hackzone/cz20-badge/speaker_grill/speaker_grill.png

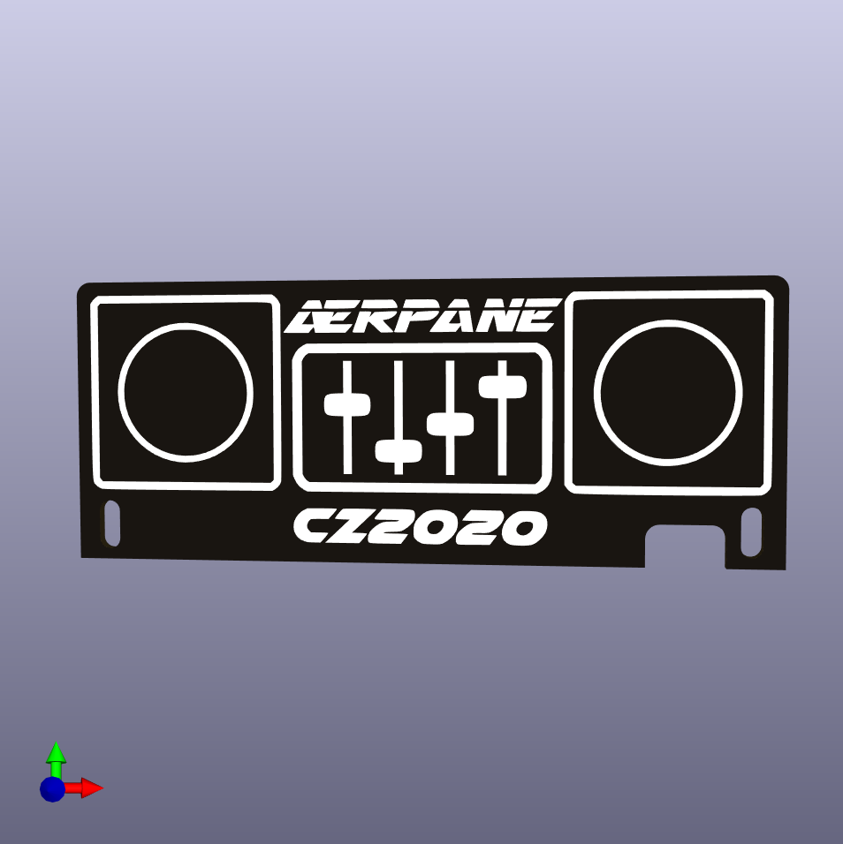
speaker_grill/speaker_grill.png
