hackzone/cz20-badge/README.md

# cz20-badge
Event badge for CampZone 2020






## [firmware-STM32](firmware-STM32)
## [bootloader-STM32](bootloader-STM32)

Use [STM32CubeIDE](https://www.st.com/en/development-tools/stm32cubeide.html)

## [firmware-ESP32](firmware-ESP32)

See [badgeteam/ESP32-platform-firmware](https://github.com/badgeteam/ESP32-platform-firmware) and [docs.badge.team](https://docs.badge.team/)

## [WebUSB site](webusb_site)

Node.js build static site for using with Hatchery over WebUSB
