hackzone/cz20-badge/speaker_grill/BoM/speaker_grill.csv

Id | Designator | Package | Quantity | Designation | Supplier and ref
1 | J4 | FFC-SMD_8P-P1.00_FFC10028-08SBD224K6M | 1 | Conn_01x08_Female
2 | J3,J2 | Molex_PicoBlade_53261-0271_1x02-1MP_P1.25mm_Horizontal | 2 | Conn_01x02_Female
3 | J1 | DNP | 1 | Conn_02x03_Odd_Even
