hackzone/cz20-badge/flashing_jig/CZ20_jig.stl

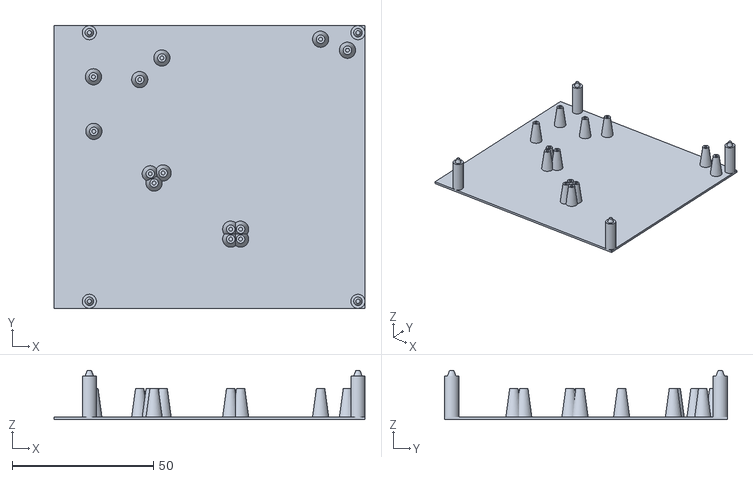
[picture p2: CAD file, 2020-07-30]
flashing_jig/CZ20_jig.stl
110.0 x 100.0 x 17.5
