hackzone/cz20-badge/hardware/hinge_light.stl

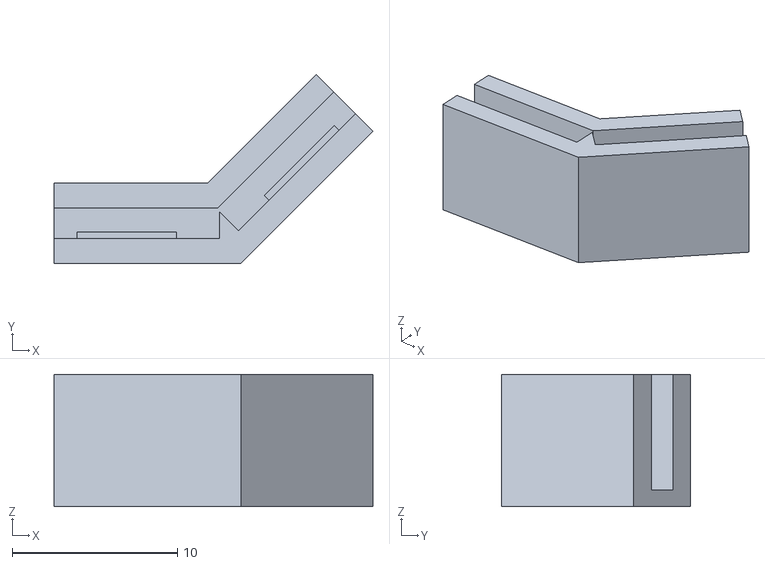
[picture p3: CAD file, 2020-07-30]
hardware/hinge_light.stl
19.3 x 11.4 x 8.00
