hackzone/cz20-badge/hardware/hinge_light_w_base.stl

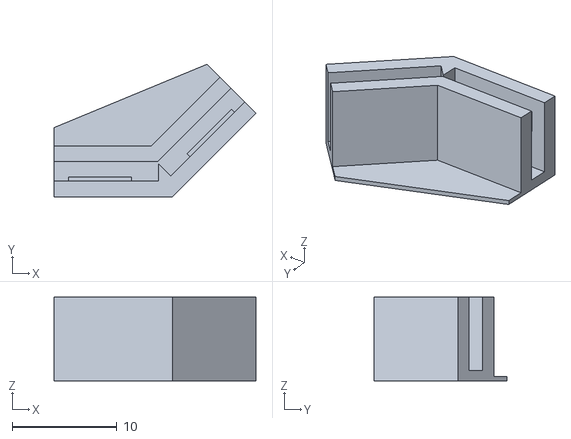
[picture p4: CAD file, 2020-07-30]
hardware/hinge_light_w_base.stl
19.3 x 12.7 x 8.00
