hackzone/cz20-badge/hardware/hinge.stl

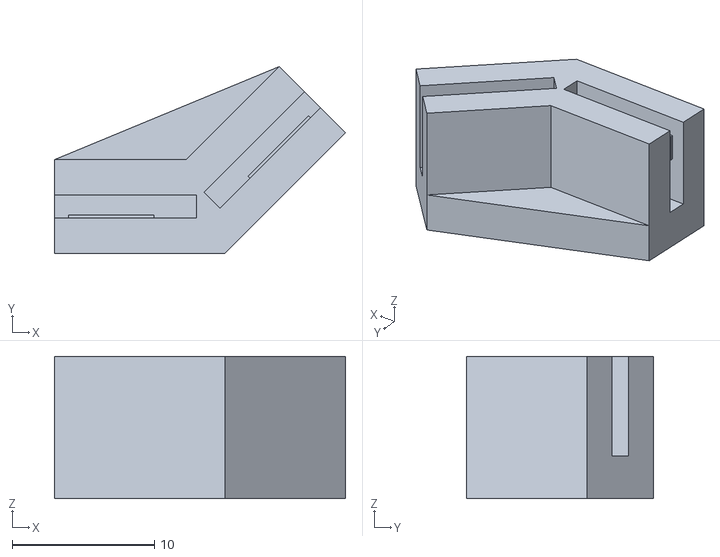
[picture p5: CAD file, 2020-05-23]
hardware/hinge.stl
20.5 x 13.2 x 10.0
