hackzone/cz20-badge/(threads)

Thread 11 (2020-07-21):

TTS loop even when having a metadata.json

therealprocyon, 2020-07-21:
I have a metadata.json set, as well as made my own app, but it becomes a buggy name and the tts keeps looping...

tjclement, 2020-07-21:
Do any errors shop up in the terminal during the loop?

therealprocyon, 2020-07-21:
` [0;37;40mStarting app 'launcher'...
>>> Preparing TTS:  Animal Crossing
TTS: Success
Preparing TTS:  Animal Crossing
Starting app 'launcher'...
>>> Starting app 'ACFAQ'...
>>> key event
i2c read error [Errno 5] EIO
key event
i2c read error [Errno 5] EIO`

tjclement, 2020-07-21:
Interesting, so even though the TTS download succeeds, it tries to download it again afterwards. Do you have /flash/cache/appnames/animal_crossing.mp3 in your file system?

therealprocyon, 2020-07-21:
No, it's named ACFAQ.mp3

therealprocyon, 2020-07-21:
On windows it says "filetype is unsupported"

tjclement, 2020-07-21:
Yeah downloading mp3 files as a zip in the web interface currently corrupts them somehow. We should log that as a separate issue; perhaps you would be kind enough to do it?

As for the TTS: does /flash/apps/ACFAQ/metadata.json exist? Note that the app "slug" name is case sensitive here

therealprocyon, 2020-07-21:
yeah it exists, apparently it generates as .MP3 with caps...

therealprocyon, 2020-07-21:
Wait, slug is missing

therealprocyon, 2020-07-21:
lemme check again

therealprocyon, 2020-07-21:
still nothing

therealprocyon, 2020-07-21:
has to do wiith it generating an all-caps filename

therealprocyon, 2020-07-21:
it generates all caps and then doesn't work when the fileslug is in all-caps

tjclement, 2020-07-21:
Cheers! Should be fixed in firmware 2104 (uploading, should be available in ~10 mins). Could you check if it works and close the issue if it does?

therealprocyon, 2020-07-21:
sure

therealprocyon, 2020-07-21:
fixed, can be closed

Closed 2020-07-21.

Thread 12 (2020-07-21):

App's failing to connect to WiFi

ijsklont, 2020-07-21:
Badge allows me to download and update firmware trough WiFi (confirmed working on both home WiFi and phone AP), however apps that require WiFi connection fail to connect to WiFi.

davidweterings, 2020-07-22:
I have similiar issues, but mine won't ever connect to my wifi (which is using an emoji), but it also won't connect to my phone's hotspot. I tried messing around a bit with the python terminal + wifi module, but no luck so far :)...

therealprocyon, 2020-07-22:
I figured how it appears to happen: there are 2 possible issues: opening settings again after having set WiFi, or on reboot by using the touch home button.

tjclement, 2020-07-22:
@renzenicolai @annejan we might want to look into the sta_if.scan() bug mentioned by @davidweterings.

@therealprocyon can you elaborate what you mean? I'm not sure I follow.

@ijsklont I'm not able to reproduce this, and have no idea what might be causing your problems. Sorry!

therealprocyon, 2020-07-22:
@tjclement if you use the home button it may reset wifi, not sure. Could also be opening settings in the browser after having set Wifi, as it blanks out when you reopen it in browser that is.

tjclement, 2020-07-22:
Yeah the home button does a full reboot, and then the launcher starts again. This is to start apps from a fresh state always. A consequence is that wifi is not connected then.

The wifi setting being cleared when you open the page again is just on the web side. We don't save the credentials, so they disappear.

therealprocyon, 2020-07-22:
that explains it.

therealprocyon, 2020-07-22:
might want to add it to the docs...

therealprocyon, 2020-07-22:
such as that people will add other ways to exit apps...

therealprocyon, 2020-07-22:
that may be the issue. What also could be nifty is having a method of storing wifi stuff on the SD, so it could be read from there.

tjclement, 2020-07-22:
I don't think that's what @ijsklont and @davidweterings are reporting: their wifi isn't working at all. Every app that uses wifi initialises it themselves (as they should). For @ijsklont, however, connecting in python apps fails, whereas the OTA update written in C works. That's odd.

therealprocyon, 2020-07-22:
ah that's odd... in my case 9/10 times it fails too

annejan, 2020-07-22:
> that may be the issue. What also could be nifty is having a method of storing wifi stuff on the SD, so it could be read from there.

The WIFI settings are stored in NVS on the badge, the webUSB site doesn't store them . .

I only have badge WiFI issues in places with terrible 2.4 GHz pollution . . where my other (5GHz) devices don't have issues . .
Wondering how I can replicate the issues you are having.

ijsklont, 2020-07-23:
After updating to 20072205 this morning, i was able to have an app connect to wifi (538 Radio). However after pressing home and test another radio app, the wifi isnt connecting anymore for all the apps.

therealprocyon, 2020-07-23:
if I init the app from the launcher, it works. otherwise it doesn't.

stitch, 2020-08-04:
My experiences with Wifi are solid, with only one workaround:

The wifi code in many of the radio apps, with the voice saying something didn't work out. Instead i wrote this routine:

No13, 2020-08-05:
I was checking newer esp-idf versions, these lib's will do the wifi handling of the ESP chip. Apparently the 'logic' of the ESP will prefer the lowest channel over a better RSSI :-/
You can supply a channel on the sta connect() function but it didn't do anything for me

Closed 2023-09-09.

Thread 13 (2020-07-22):

Bootloop: "Generating a spoken name for app"

D3xtar, 2020-07-22:
Badge runs into a bootloop, and keeps repeating " Generating a spoken name for app" , following a short beep which seems to be caused by the reboot that follows.

Actions that have been done that could possibly triggered this bootloop:

-Updated to the newest firmware
-Installed/Deinstalled some apps from the store,
-Made a test-app through the web-interface. Manually made some directories and files in the "Apps" -folder.
-Moved around some buttons.

All apps have been removed, but the problem persists. Apps are bootable when you press the button right before the spoken message.

Terminal output:
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

D3xtar, 2020-07-22:
Update: Removed SD card and booted. Spoken name is now generated correctly! After reinserting the SD still no errors.

tjclement, 2020-07-22:
Fascinating, thanks for reporting. I'll try to reproduce this later

jorisplusplus, 2020-07-22:
Disabling Use interrupt for MPI operations seems to fix the bootloop and will generate the tts files while sd card is present. Impact of this change is unknown

tjclement, 2020-07-22:
Testing now

tjclement, 2020-07-22:
Fixed in firmware 2205! Please reopen the issue if you're still having trouble

Closed 2020-07-22.

Thread 14 (2020-07-22):

Reboots when starting app launcher (or other apps)

D3xtar, 2020-07-22:
After creating/deleting some files in the Apps folder, the launcher app crashes. Terminal shows the following output:

`BADGE.TEAM
Starting app 'launcher'...
>>> assertion "0 && "fatfs internal error"" failed: file "/Users/tom/Git/cz20-badge/firmware-ESP32/esp-idf/components/fatfs/src/vfs_fat.c", line 251, function: fresult_to_errno
abort() was called at PC 0x40119cdb on core 1

Backtrace: 0x4009318f:0x3ffc0bc0 0x40093489:0x3ffc0be0 0x40119cdb:0x3ffc0c00 0x4018777c:0x3ffc0c30 0x40187a4a:0x3ffc0c50 0x40134e46:0x3ffc0c80 0x4000bdbb:0x3ffc0ca0 0x400017ea:0x3ffc0cc0 0x4010bb51:0x3ffc0ce0 0x40119996:0x3ffc0d00 0x40146754:0x3ffc0d20 0x40145966:0x3ffc0d50 0x40145b06:0x3ffc0d90

Rebooting...
ets Jul 29 2019 12:21:46

rst:0xc (SW_CPU_RESET),boot:0x13 (SPI_FAST_FLASH_BOOT)
configsip: 0, SPIWP:0xee
clk_drv:0x00,q_drv:0x00,d_drv:0x00,cs0_drv:0x00,hd_drv:0x00,wp_drv:0x00
mode:DIO, clock div:1
load:0x3fff0018,len:4
load:0x3fff001c,len:5192
load:0x40078000,len:9088
ho 0 tail 12 room 4
load:0x40080400,len:6652
entry 0x400806f8
`
This appears every 2 seconds.

Web interface is accessible. Pressing a button to start an app does not start the app..

D3xtar, 2020-07-22:
Message disppears when removing all apps, bu re-appears when installing an app from the store. Starting apps not possible.

D3xtar, 2020-07-22:
Also appears when starting other apps:

BADGE.TEAM
Starting app 'qmusic_radio'...
assertion "0 && "fatfs internal error"" failed: file "/Users/tom/Git/cz20-badge/firmware-ESP32/esp-idf/components/fatfs/src/vfs_fat.c", line 251, function: fresult_to_errno
abort() was called at PC 0x40119cdb on core 1

Backtrace: 0x4009318f:0x3ffd59b0 0x40093489:0x3ffd59d0 0x40119cdb:0x3ffd59f0 0x4018777c:0x3ffd5a20 0x40187a4a:0x3ffd5a40 0x40134e46:0x3ffd5a70 0x4000bdbb:0x3ffd5a90 0x400017ea:0x3ffd5ab0 0x4010bb51:0x3ffd5ad0 0x40119996:0x3ffd5af0 0x40146754:0x3ffd5b10 0x40145966:0x3ffd5b40 0x40145b06:0x3ffd5b80

Rebooting...
ets Jul 29 2019 12:21:46

rst:0xc (SW_CPU_RESET),boot:0x13 (SPI_FAST_FLASH_BOOT)
configsip: 0, SPIWP:0xee
clk_drv:0x00,q_drv:0x00,d_drv:0x00,cs0_drv:0x00,hd_drv:0x00,wp_drv:0x00
mode:DIO, clock div:1
load:0x3fff0018,len:4
load:0x3fff001c,len:5192
load:0x40078000,len:9088
ho 0 tail 12 room 4
load:0x40080400,len:6652
entry 0x400806f8

D3xtar, 2020-07-22:
In every attemp to start an app this lie always show up:

"fatfs internal error"" failed: file "/Users/tom/Git/cz20-badge/firmware-ESP32/esp-idf/components/fatfs/src/vfs_fat.c",

tjclement, 2020-07-22:
This looks like the FS got corrupted somehow. Maybe the file allocation table is bad. That's unfortunate, because we don't have an easy way to fix this yet. Let's PM about what to do for you. I'll leave this issue open so others can find it, should they run into the same problem (if you do, please add a message here).

D3xtar, 2020-07-22:
Restored ESP by reflashing. Thank you!

D3xtar, 2020-07-22:
After making some new folders/files the problem reappeared:

BADGE.TEAM
Starting app 'qmusic_radio'...
assertion "0 && "fatfs internal error"" failed: file "/Users/tom/Git/cz20-badge/firmware-ESP32/esp-idf/components/fatfs/src/vfs_fat.c", line 251, function: fresult_to_errno
abort() was called at PC 0x40119cdb on core 1

Backtrace: 0x4009318f:0x3ffd59b0 0x40093489:0x3ffd59d0 0x40119cdb:0x3ffd59f0 0x4018777c:0x3ffd5a20 0x40187a4a:0x3ffd5a40 0x40134e46:0x3ffd5a70 0x4000bdbb:0x3ffd5a90 0x400017ea:0x3ffd5ab0 0x4010bb51:0x3ffd5ad0 0x40119996:0x3ffd5af0 0x40146754:0x3ffd5b10 0x40145966:0x3ffd5b40 0x40145b06:0x3ffd5b80

Rebooting...
ets Jul 29 2019 12:21:46

rst:0xc (SW_CPU_RESET),boot:0x13 (SPI_FAST_FLASH_BOOT)
configsip: 0, SPIWP:0xee
clk_drv:0x00,q_drv:0x00,d_drv:0x00,cs0_drv:0x00,hd_drv:0x00,wp_drv:0x00
mode:DIO, clock div:1
load:0x3fff0018,len:4
load:0x3fff001c,len:5192
load:0x40078000,len:9088
ho 0 tail 12 room 4
load:0x40080400,len:6652
entry 0x400806f8

reflashed  and everything works again.

tjclement, 2020-07-22:
Can you describe the folders/files? If you're not doing anything crazy, you might have faulty flash storage. If so, we'll arrange something for you.

annejan, 2020-07-22:
If after reflash no more issues . . then that's it . .

If you continue to experience issues . . you'll need a replacement board / ESP 😉

Closed 2020-07-22.

Thread 15 (2020-07-22):

Apps fail to update

xesxen, 2020-07-22:
The WebUSB environment tries to create the paths it needs when installing an app (https://github.com/hackzone/cz20-badge/blob/master/webusb_site/src/components/Apps.vue#L221). When updating, this isn't needed.

As it currently doesn't take this into account, the Javascript promise will fail which results in the vue component ending up in an improper state (you cannot install anymore apps till you refresh).

tjclement, 2020-07-22:
This fix will be pushed momentarily (together with progress bar update)

tjclement, 2020-07-22:
Fixed

Closed 2020-07-22.

Thread 16 (2020-07-22):

[Feature request] Adding optional settings fields in the "Configure home screen buttons"

MrDiba, 2020-07-22:
I have build the MQTT button app where the user needs to enter information (MQTT server IP, and topic) in the code before the application can be used.

It would be great if the user can enter the information on the "configure home screen buttons" and that it is parsed over to the application. I do not know if it is (technically) possible or not, but I would like to throw the suggestion.

The idea is that the app creator can add fields (text boxes, radio buttons, ...) to the selected app in the "configure home screen buttons" view. A placeholder variable can be placed in the Python code in the app, and when information is entered in the field the data will be parsed to the variable in the Python code.

tjclement, 2020-07-22:
Wonderful idea, and already implemented! 😁 https://docs.badge.team/esp32-app-development/api-reference/appconfig/

This adds per-app boxes to the Settings page after your app first runs:
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

Closed 2020-07-22.

Thread 19 (2020-07-23):

Generating spoken name for app message after assigning local app to button

D3xtar, 2020-07-23:
I manually created some directories under the " Apps"  folder to store my own projects.

When assigning such a project to one of the buttons, the message "generating spoken name for app" appears every time you return to the home-state with the home-button.

Terminal screen output: Skipping app name generation due to earlier error.

tjclement, 2020-07-23:
Fixed in firmware 2307!

Closed 2020-07-23.

Thread 22 (2020-07-23):

[webusb site] Programming view is broken after switching to another view

tjclement, 2020-07-23:
Throws an error about handleLog not being available on undefined object.

tjclement, 2020-07-23:
Fixed in latest webusb release

Closed 2020-07-23.

Thread 24 (2020-07-24):

Feature request: Possibility to record samples in webui

jillesdotcom, 2020-07-24:
Allow users to record mono samples @ 22.050 128kps in the Webui and upload those to /flash/cache/samples/sample<n>.mp3
Users are able to move those to different apps and rename them accordingly.

sknebel, 2020-08-01:
Since I had looked at some pieces that would be relevant recently, here's some hints for a potential implementation:

You'll need to bring your own MP3 encoder. There are a few projects that have compiled LAME to JS or WASM through emscripten, e.g. https://github.com/Kagami/vmsg

What it is missing is a sample-rate conversion - this could either be done by adding some conversion code to the C module or by pre-converting in JS.

sknebel, 2020-08-01:
addendum: to state it explicitly, I'd be willing to help figure some of this out, but can't do the integration into the app since I missed out on a badge and thus can't run/test it.

annejan, 2020-08-02:
I have conversion options in Hatchery, I can setup an opus to mp3 converter somewhere coming week.

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

--
Sent from my badge prototype
