hackzone/cz20-badge/hardware/pdf/cz-badge-hardware-B_SilkS.pdf

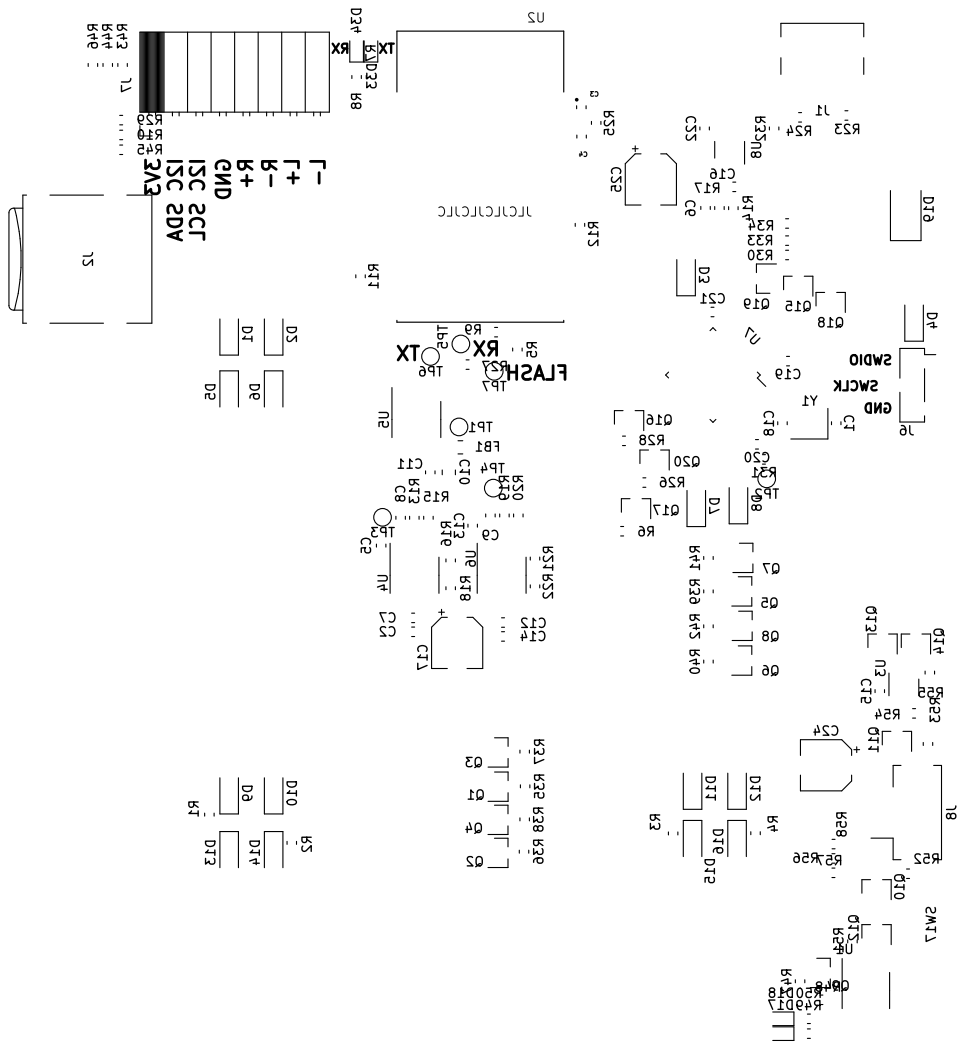
[picture p6: page 1]

FLASH 3V3 I2C SDA I2C SCL GND R+R- L+L- GND
