hackzone/cz20-badge/hardware/pdf/cz-badge-hardware-F_SilkS.pdf

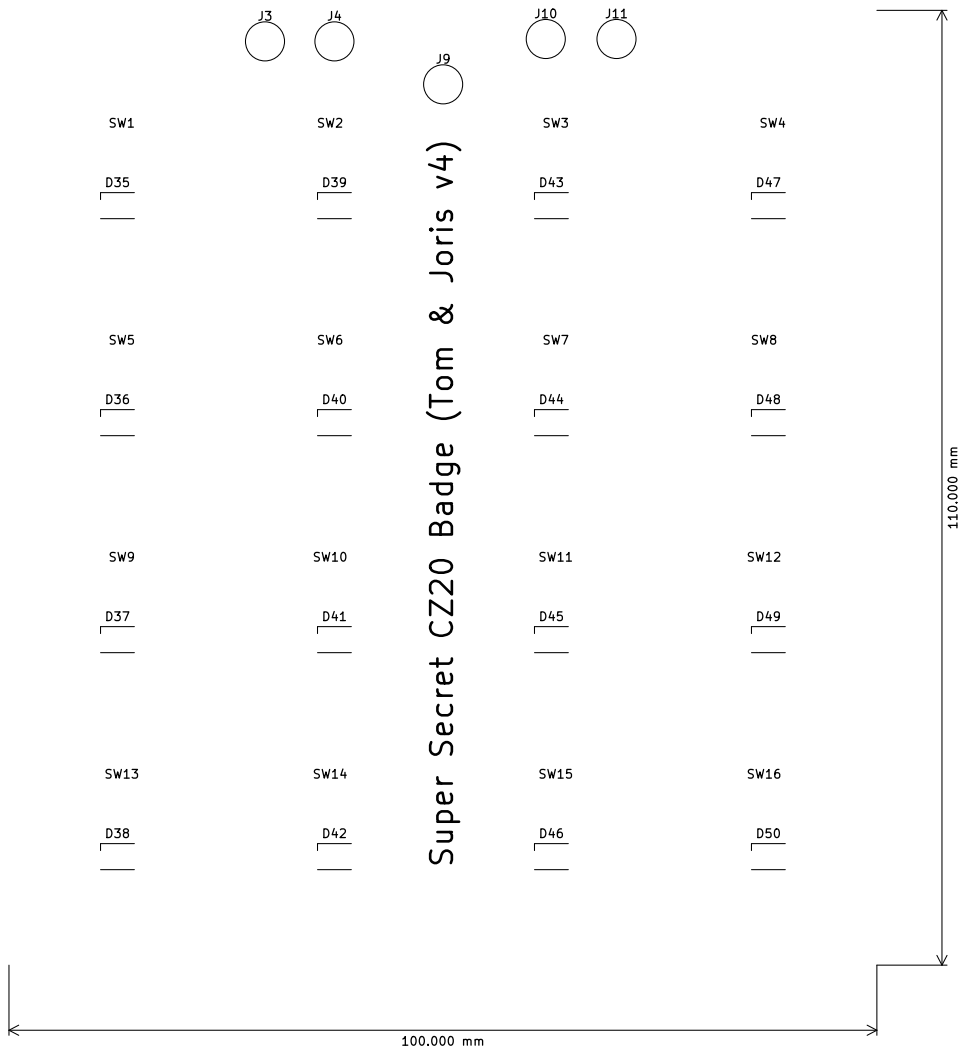
[picture p7: page 1]

100.000 mm Super Secret CZ20 Badge (Tom & Joris v4)
