hackzone/cz20-badge/speaker_grill/pdf/panel-B_Mask.pdf

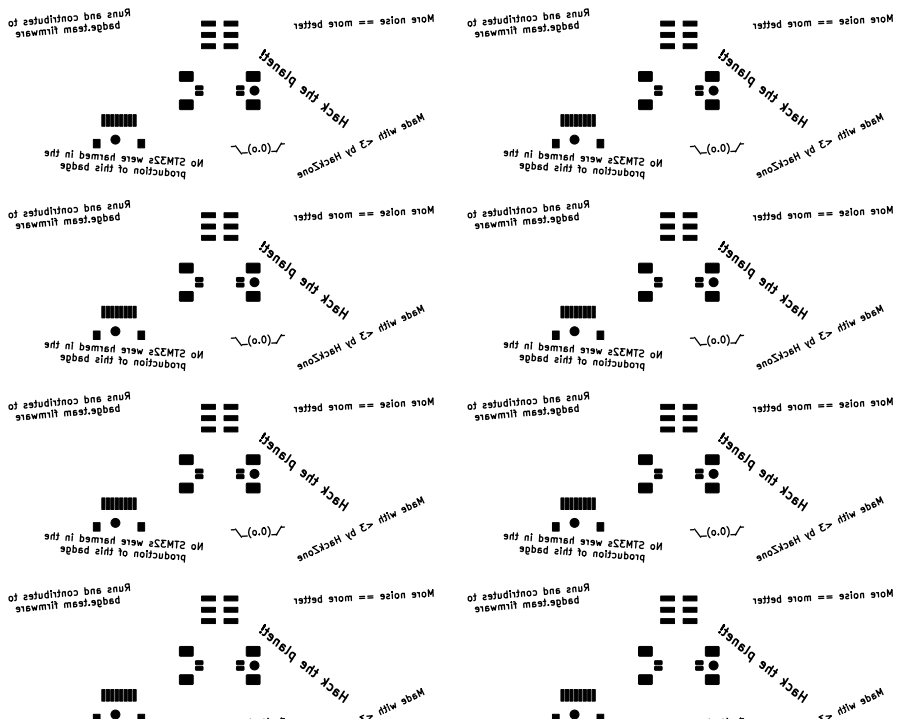
[picture p8: page 1]

Runs and contributes to badge.team firmware

More noise == more better

Hack the planet! Made with <3 by HackZone

No STM32s were harmed in the production of this badge
