hackzone/cz20-badge/speaker_grill/pdf/panel-Cmts_User.pdf

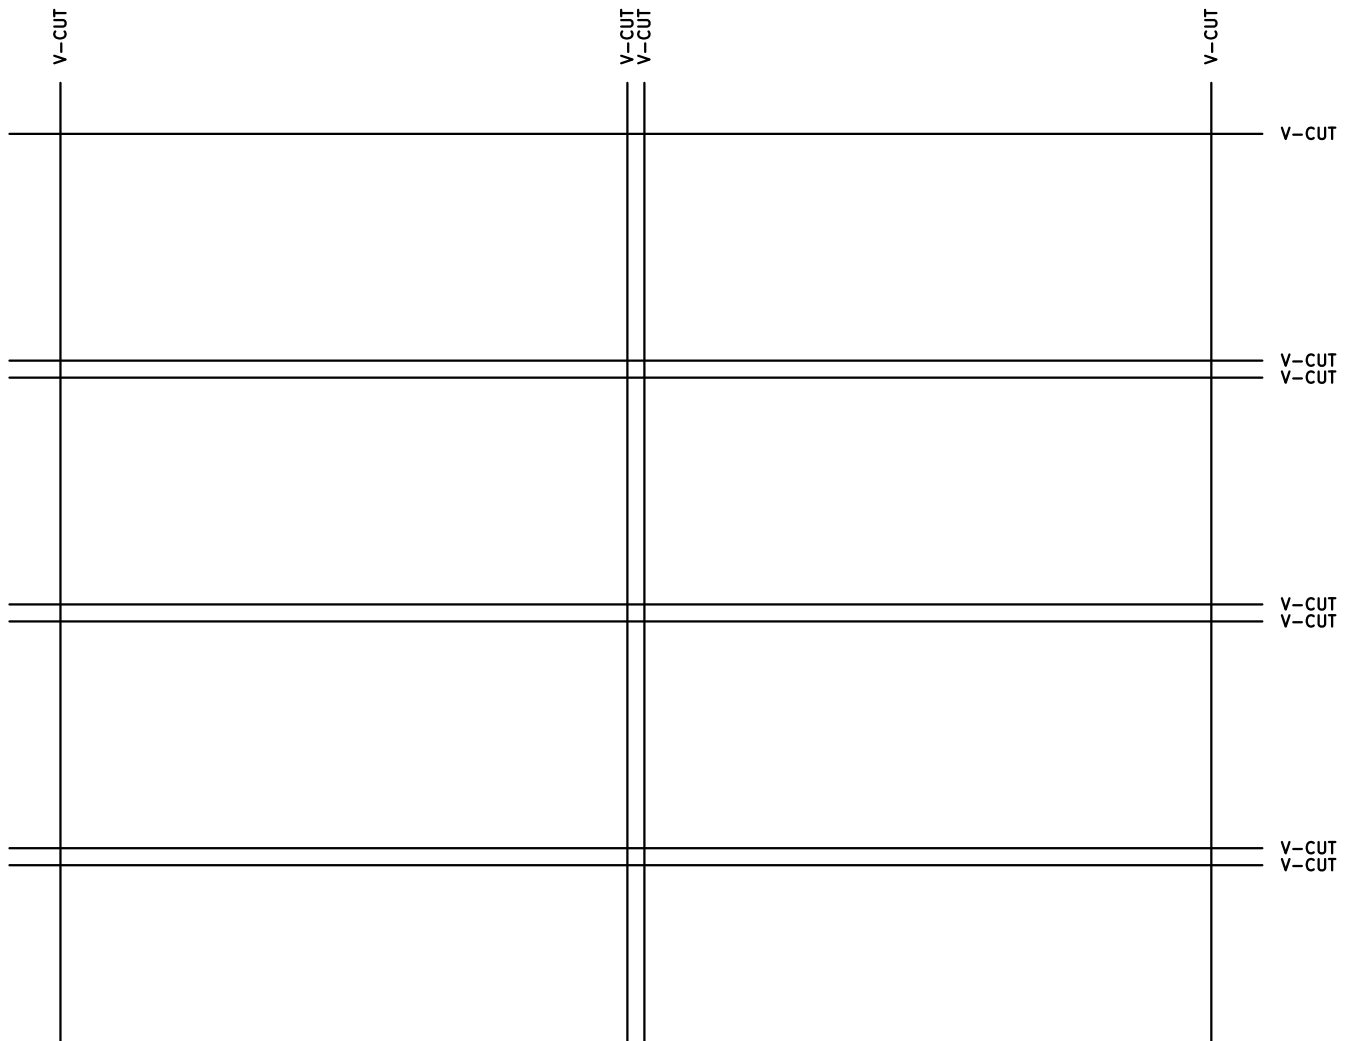
[picture p9: page 1]

V-CUT V-CUT
