hackzone/cz20-badge/hardware/pdf/cz-badge-hardware-B_CrtYd.pdf

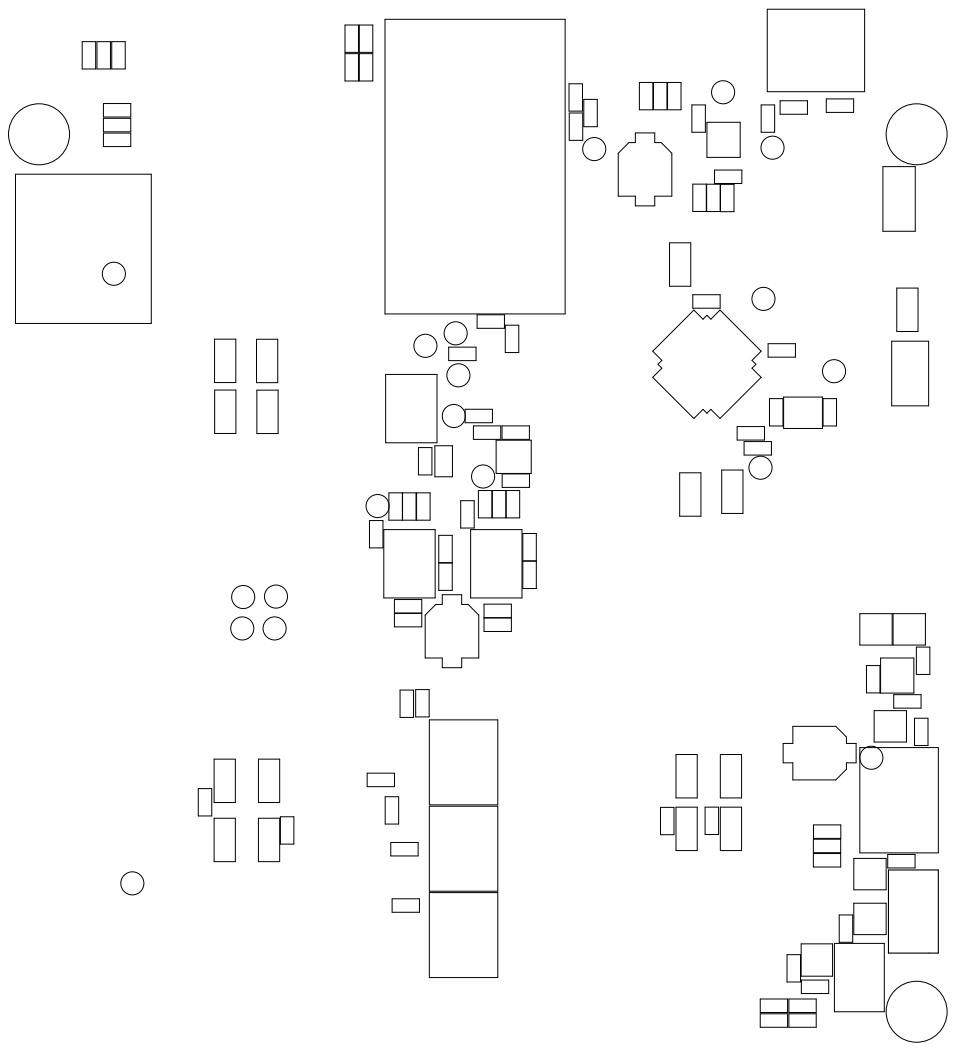
[picture p10: page 1]
