hackzone/cz20-badge/hardware/pdf/cz-badge-hardware-F_CrtYd.pdf

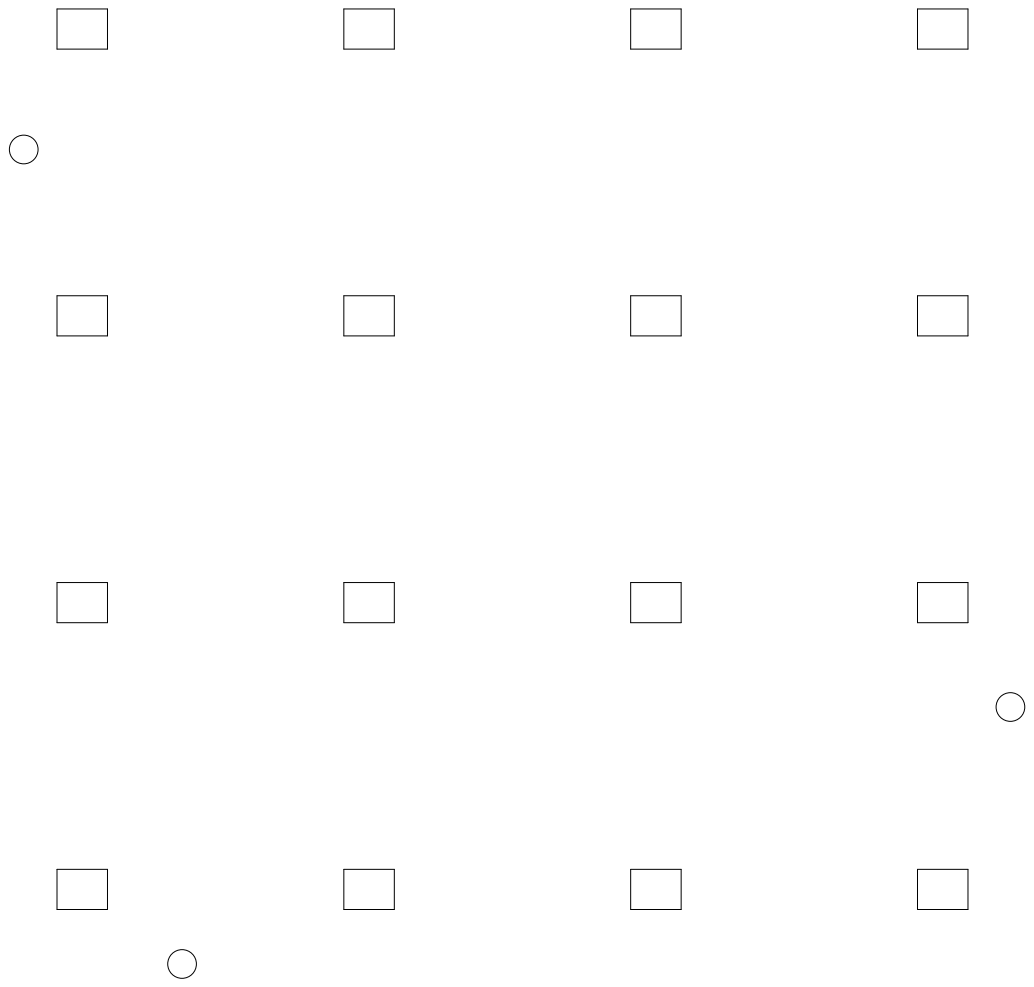
[picture p11: page 1]
