hackzone/cz20-badge/hardware/pdf/cz-badge-hardware-B_Cu.pdf

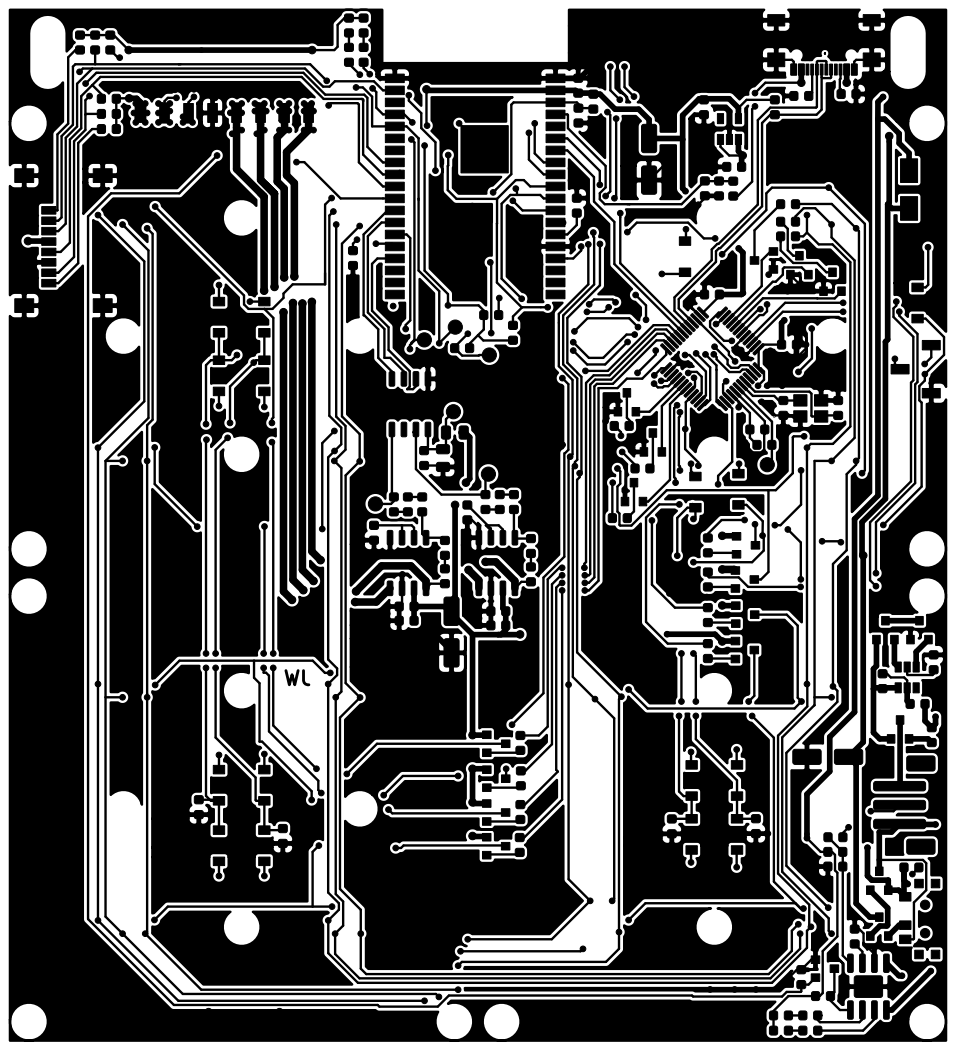
[picture p12: page 1]
