hackzone/cz20-badge/hardware/pdf/cz-badge-hardware-B_Fab.pdf

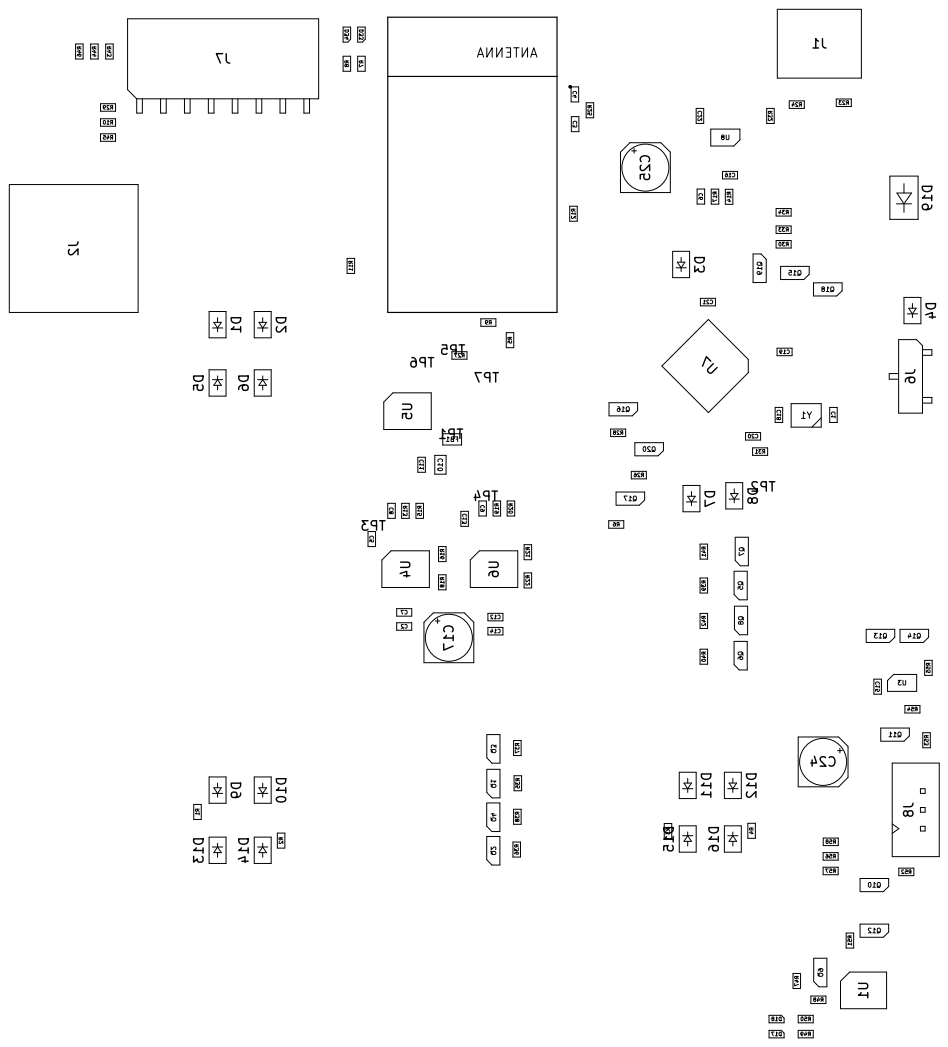
[picture p13: page 1]
