hackzone/cz20-badge/hardware/pdf/cz-badge-hardware-B_Mask.pdf

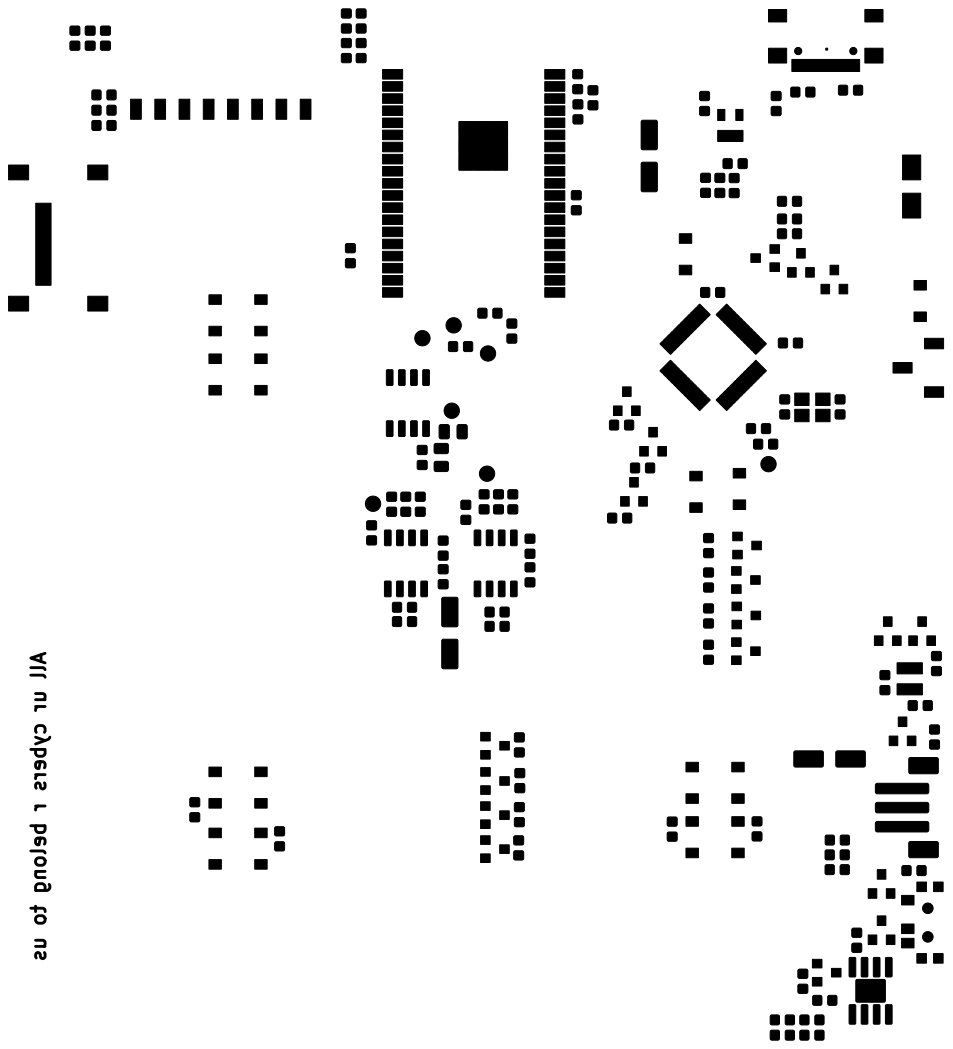
[picture p14: page 1]

All ur cybers r belong to us
