hackzone/cz20-badge/hardware/pdf/cz-badge-hardware-B_Paste.pdf

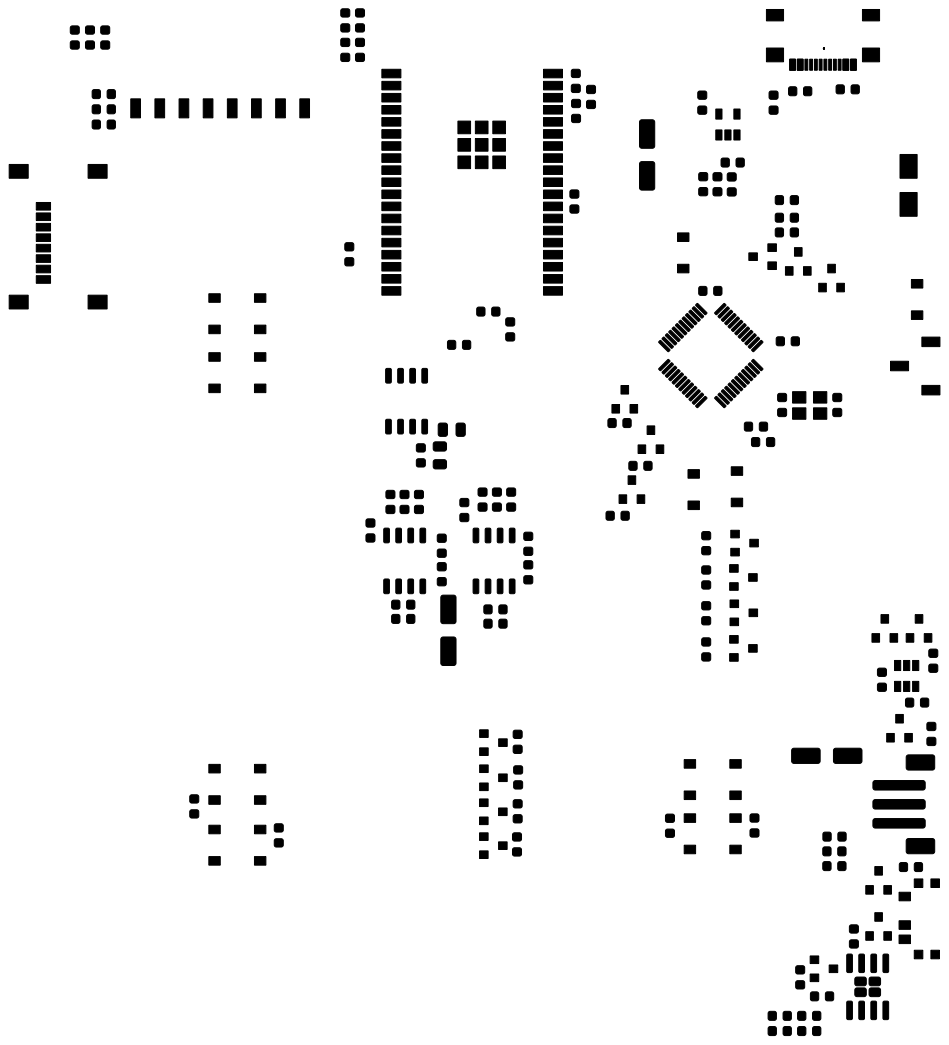
[picture p15: page 1]
