hackzone/cz20-badge/hardware/pdf/cz-badge-hardware-Edge_Cuts.pdf

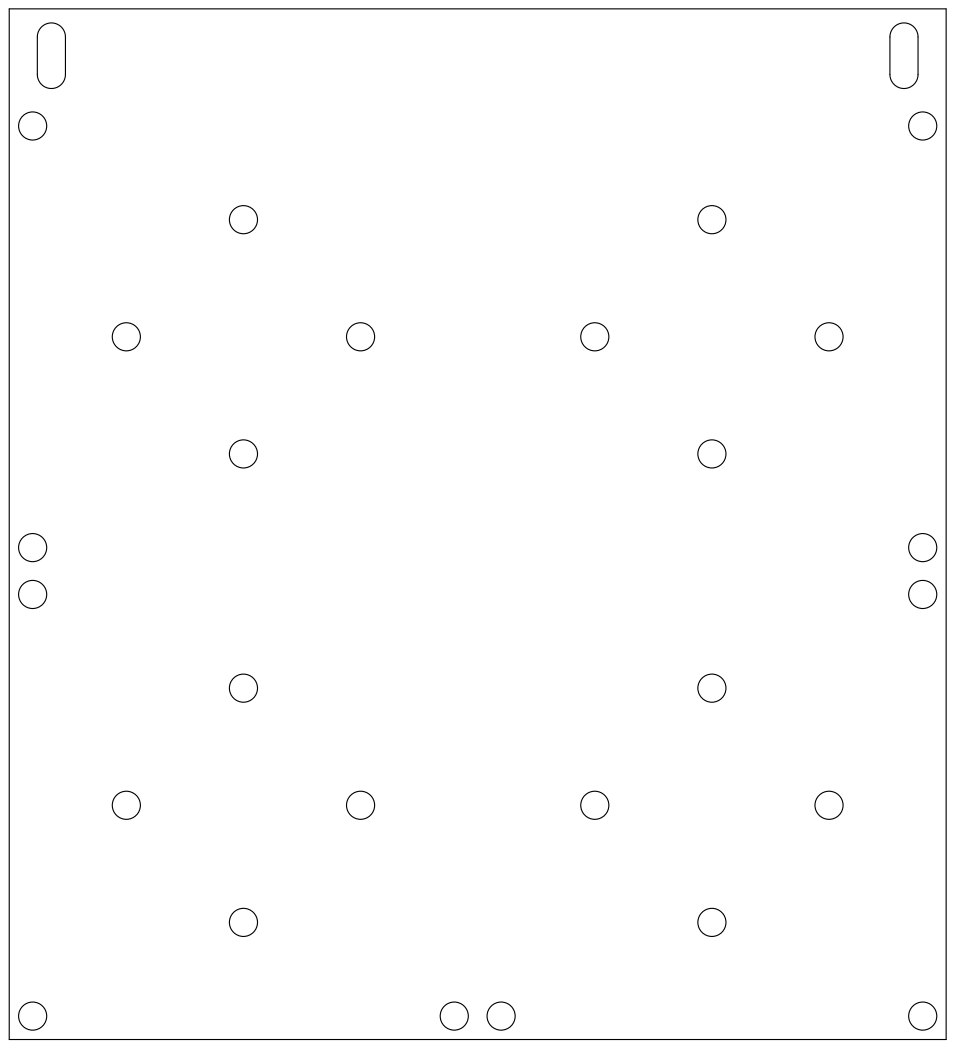
[picture p16: page 1]
