hackzone/cz20-badge/hardware/pdf/cz-badge-hardware-F_Cu.pdf

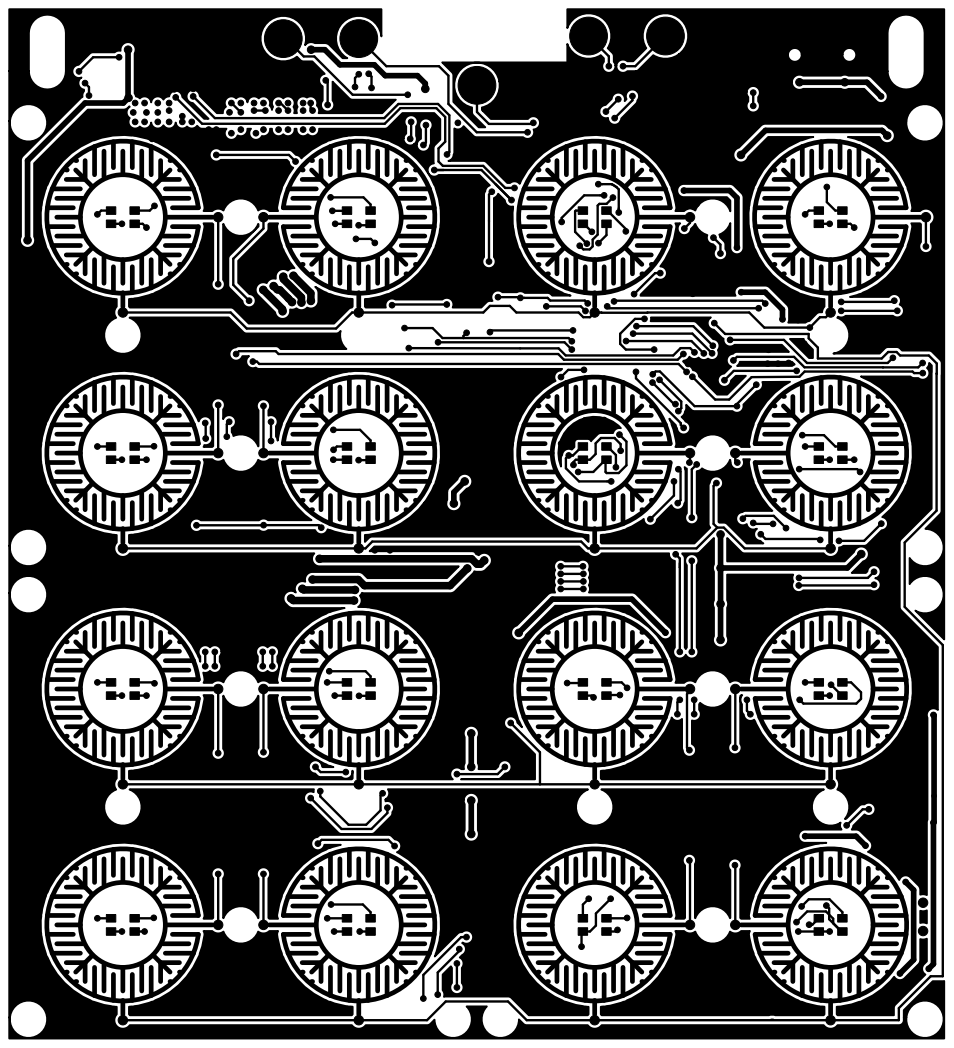
[picture p17: page 1]
