hackzone/cz20-badge/hardware/pdf/cz-badge-hardware-F_Fab.pdf

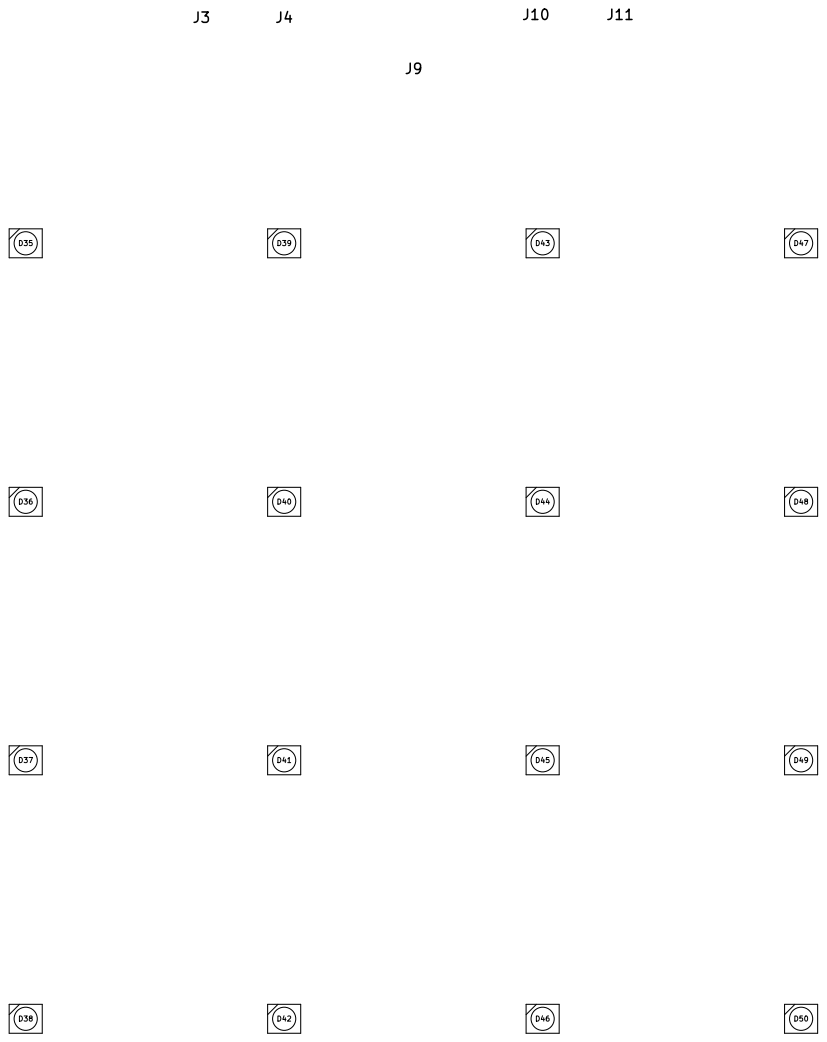
[picture p18: page 1]
