hackzone/cz20-badge/hardware/pdf/cz-badge-hardware-F_Mask.pdf

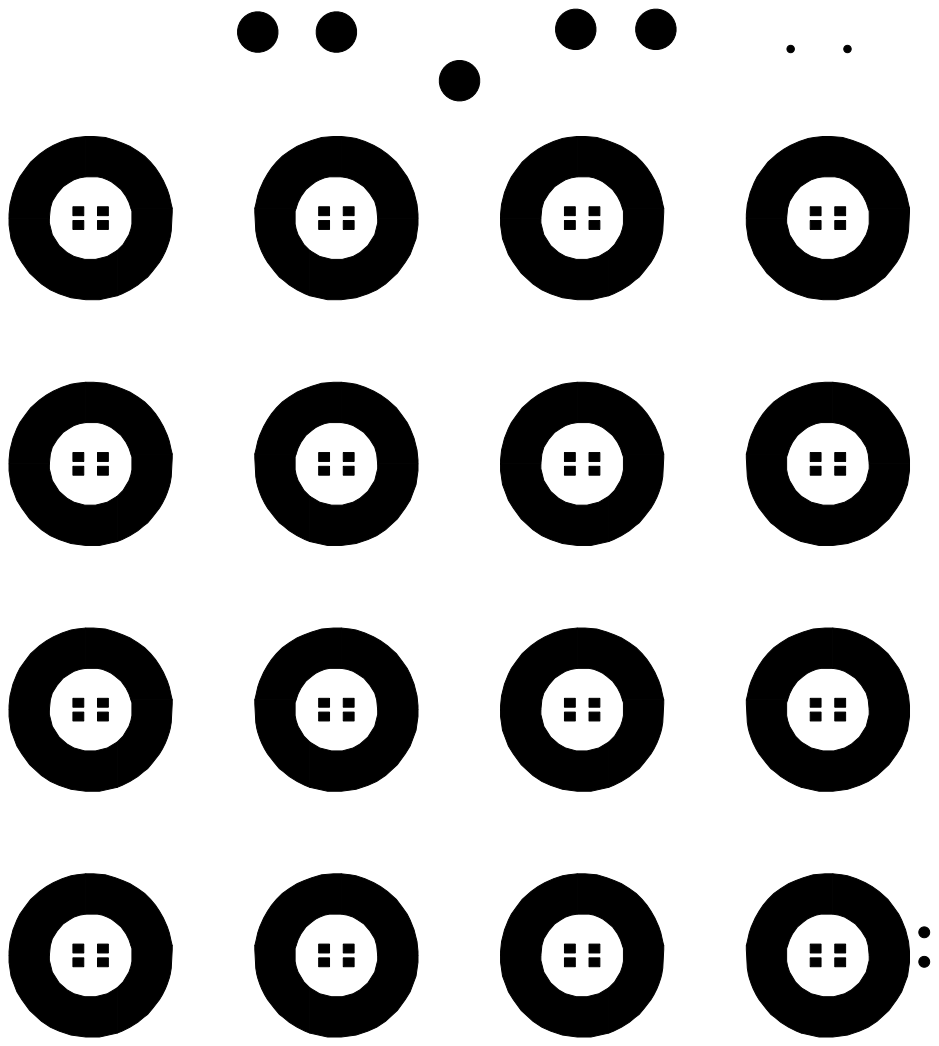
[picture p19: page 1]
