hackzone/cz20-badge/hardware/pdf/cz-badge-hardware-F_Paste.pdf

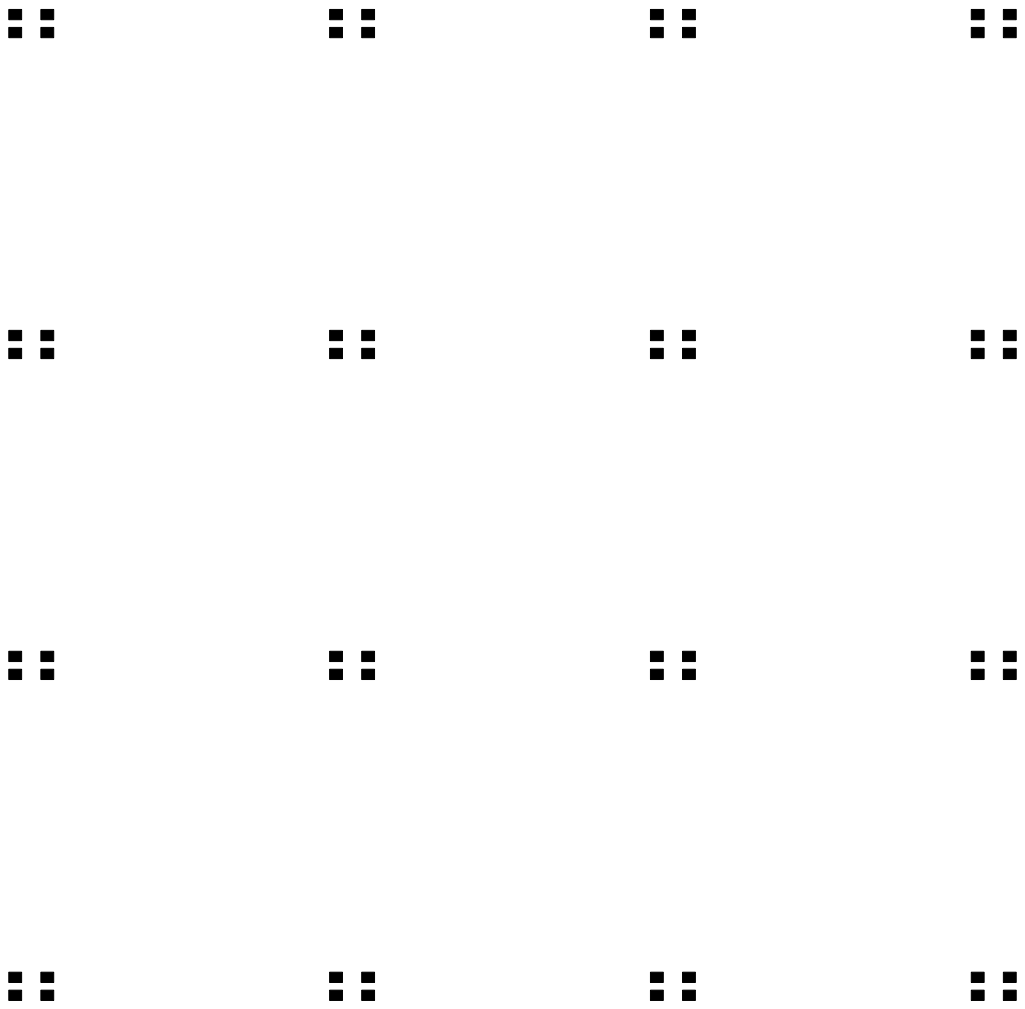
[picture p20: page 1]
