hackzone/cz20-badge/speaker_grill/pdf/panel-B_CrtYd.pdf

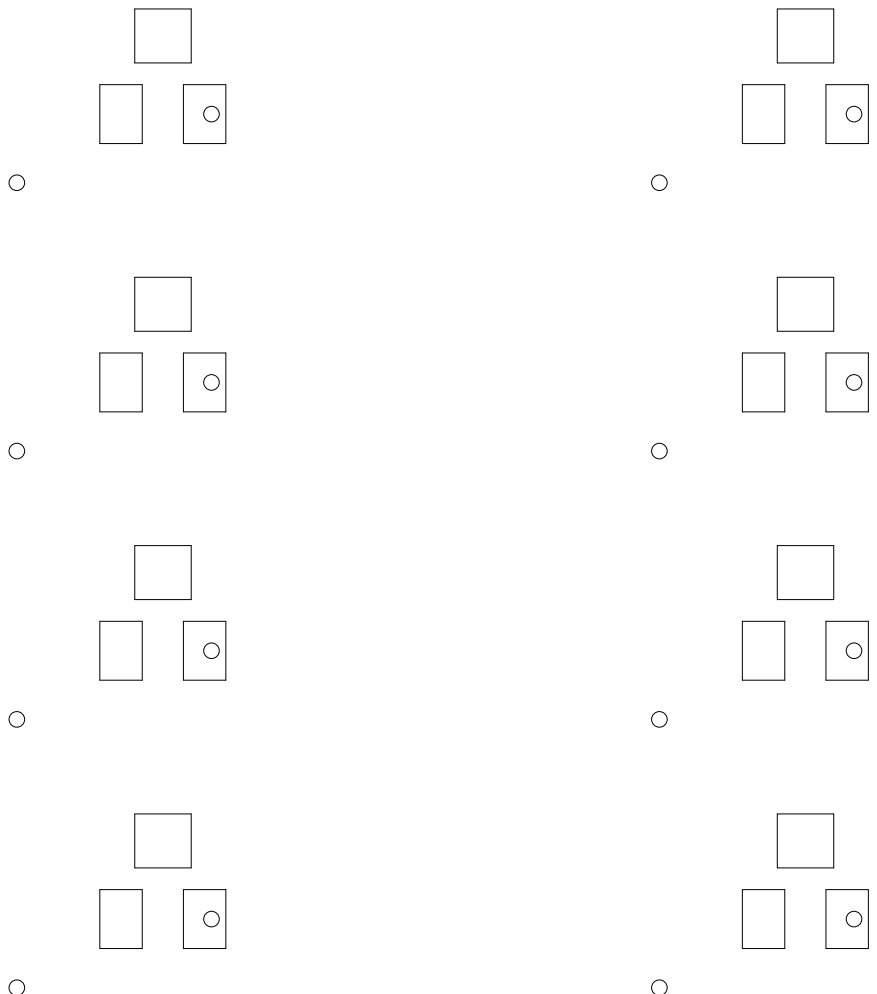
[picture p21: page 1]
