hackzone/cz20-badge/speaker_grill/pdf/panel-B_Cu.pdf

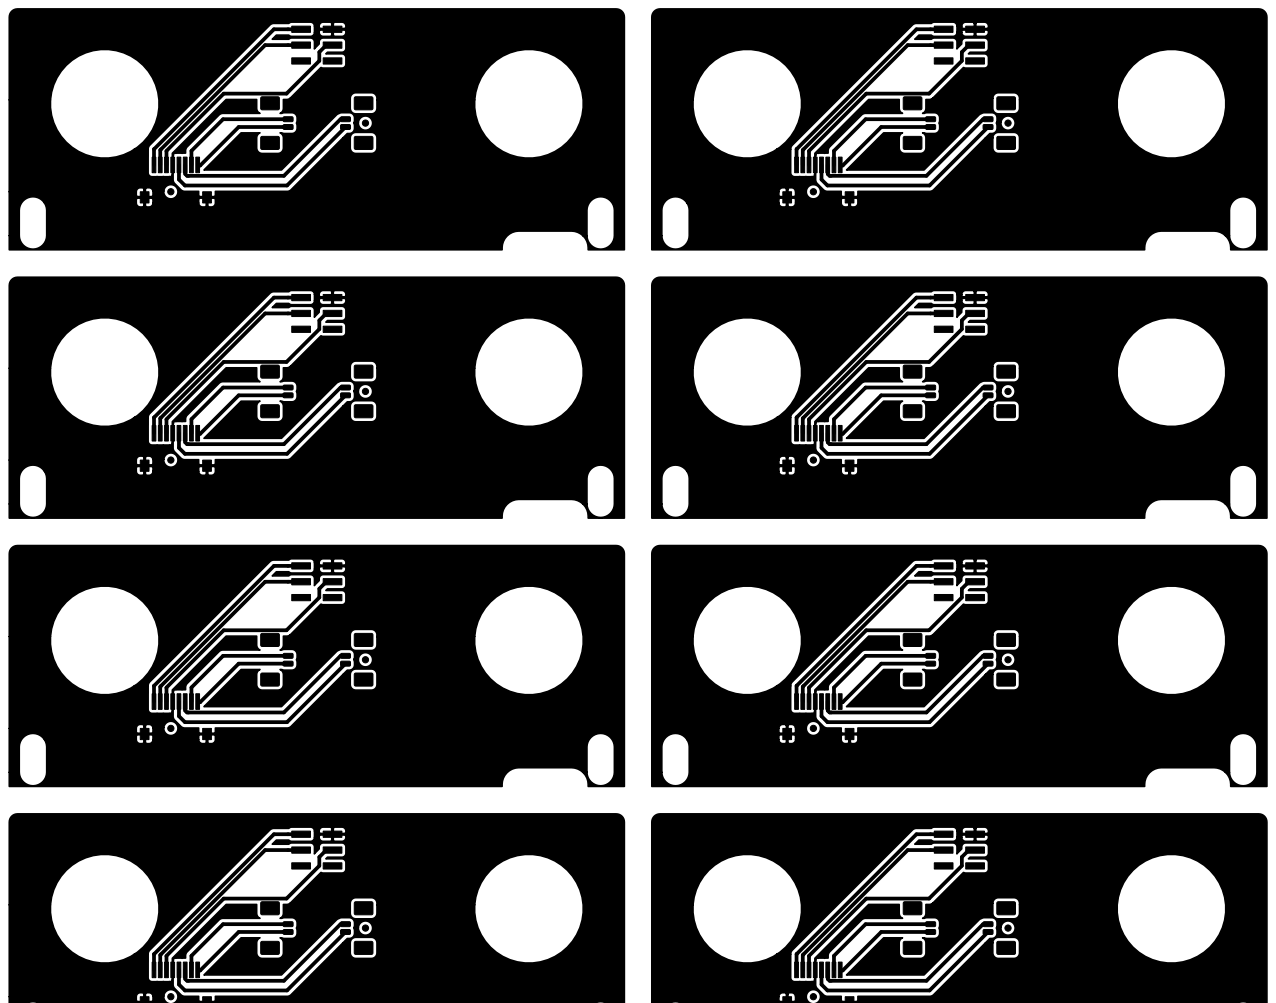
[picture p22: page 1]
