hackzone/cz20-badge/speaker_grill/pdf/panel-B_Fab.pdf

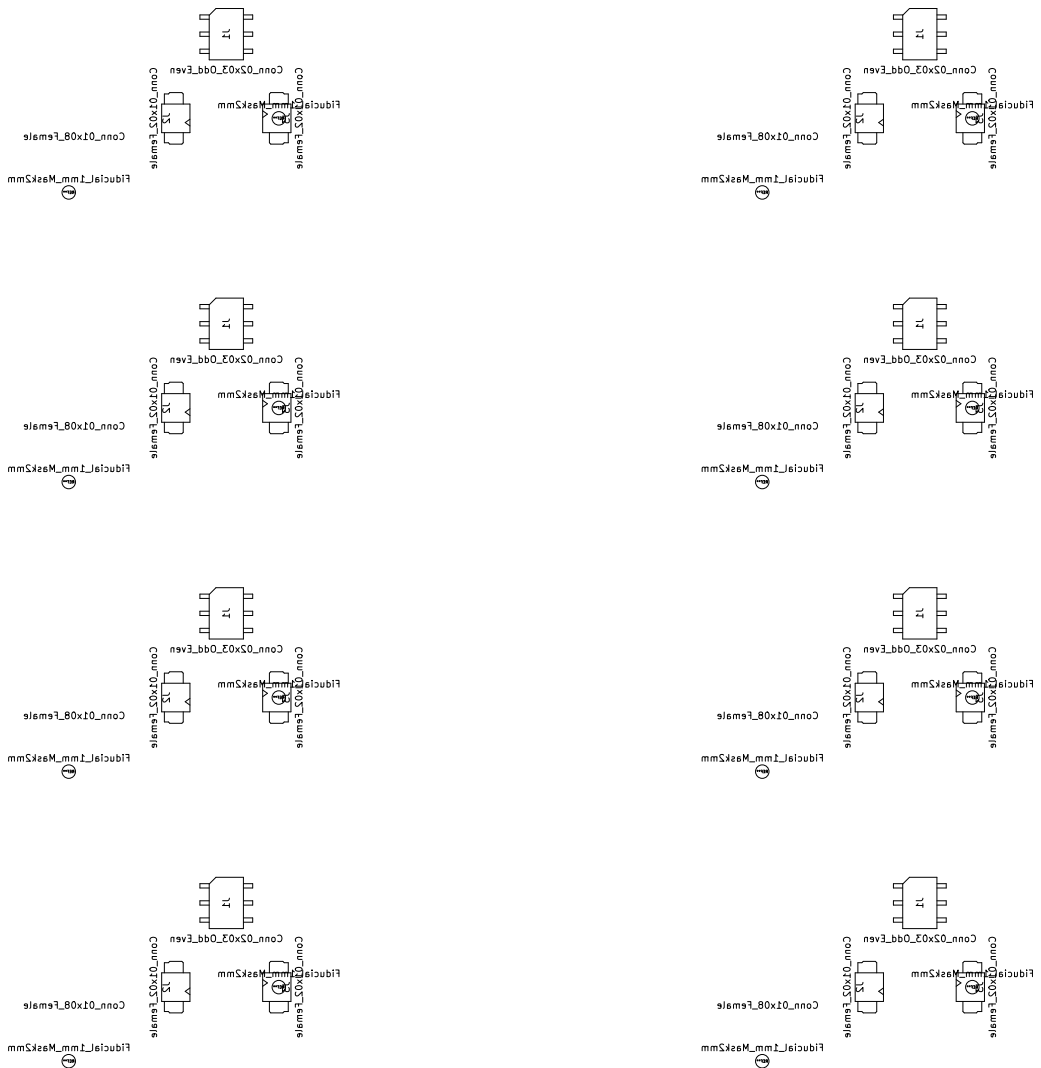
[picture p23: page 1]
