hackzone/cz20-badge/speaker_grill/pdf/panel-B_Paste.pdf

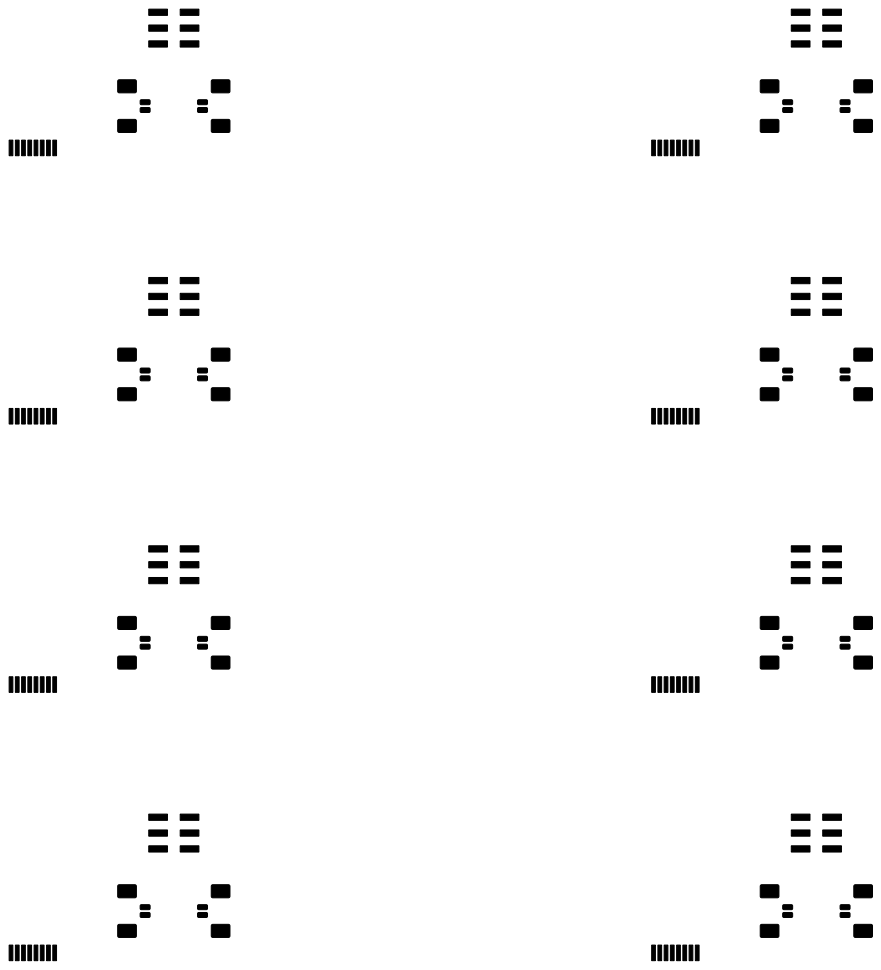
[picture p24: page 1]
