hackzone/cz20-badge/speaker_grill/pdf/panel-B_SilkS.pdf

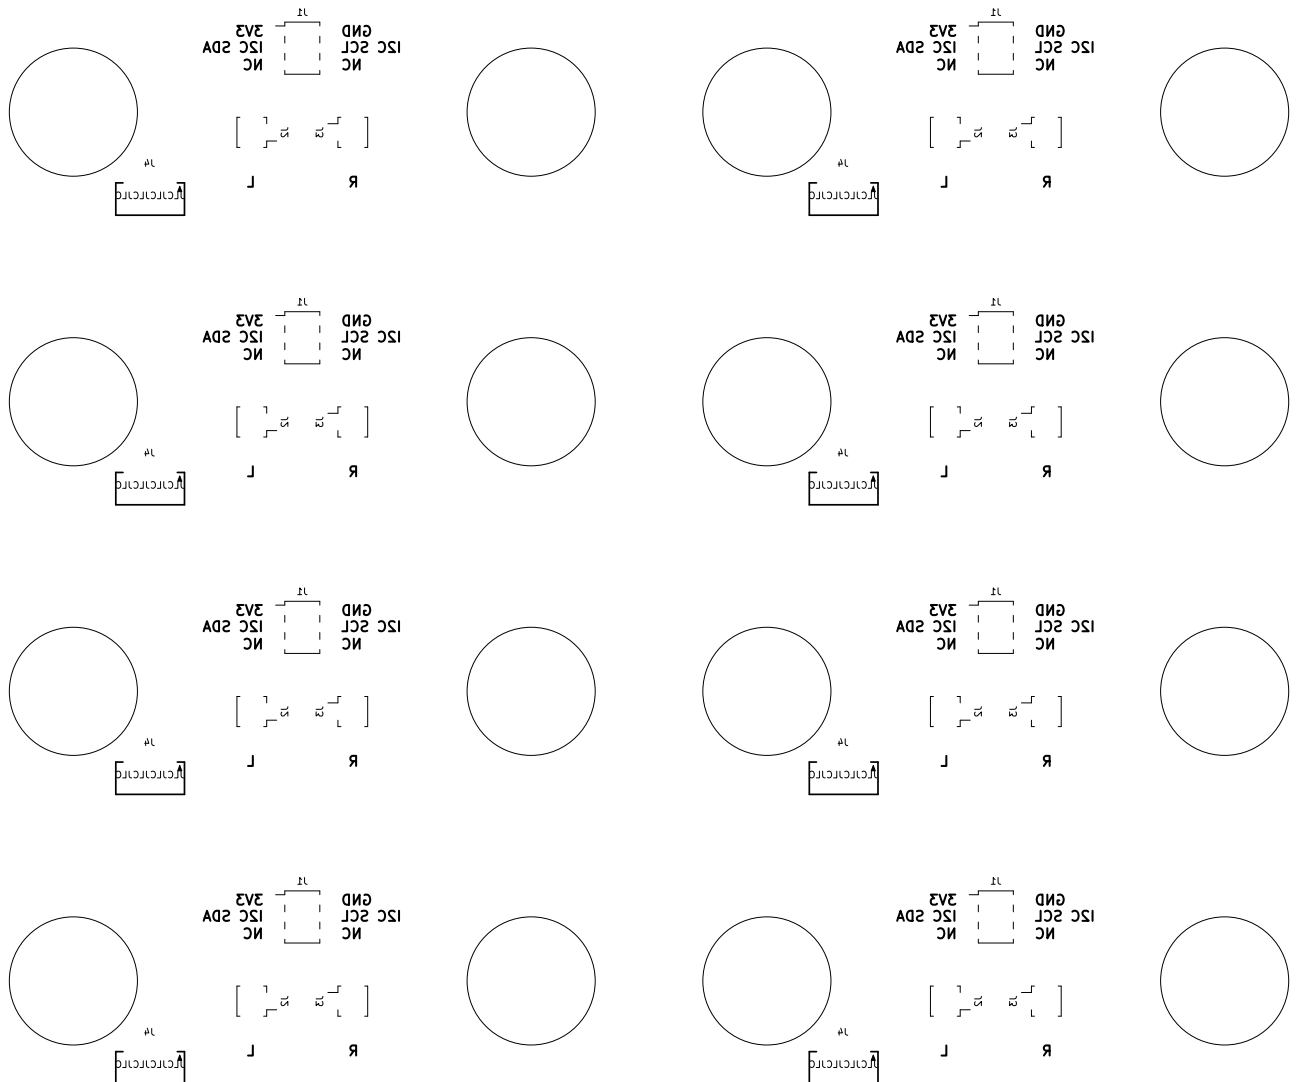
[picture p25: page 1]
