hackzone/cz20-badge/speaker_grill/pdf/panel-Edge_Cuts.pdf

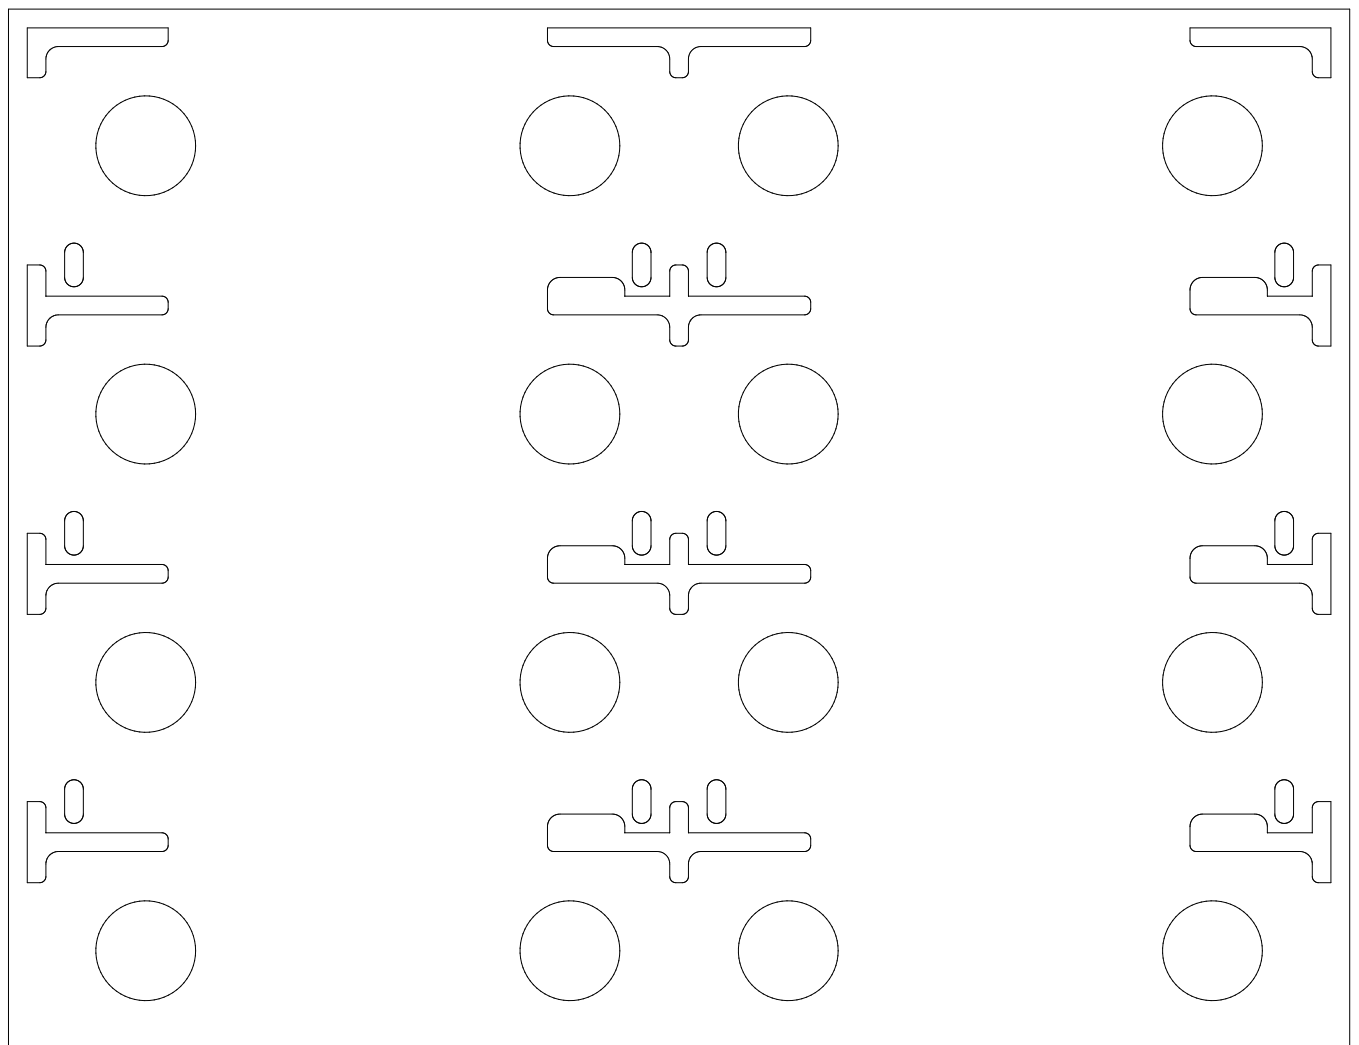
[picture p26: page 1]
