hackzone/cz20-badge/speaker_grill/pdf/panel-F_Cu.pdf

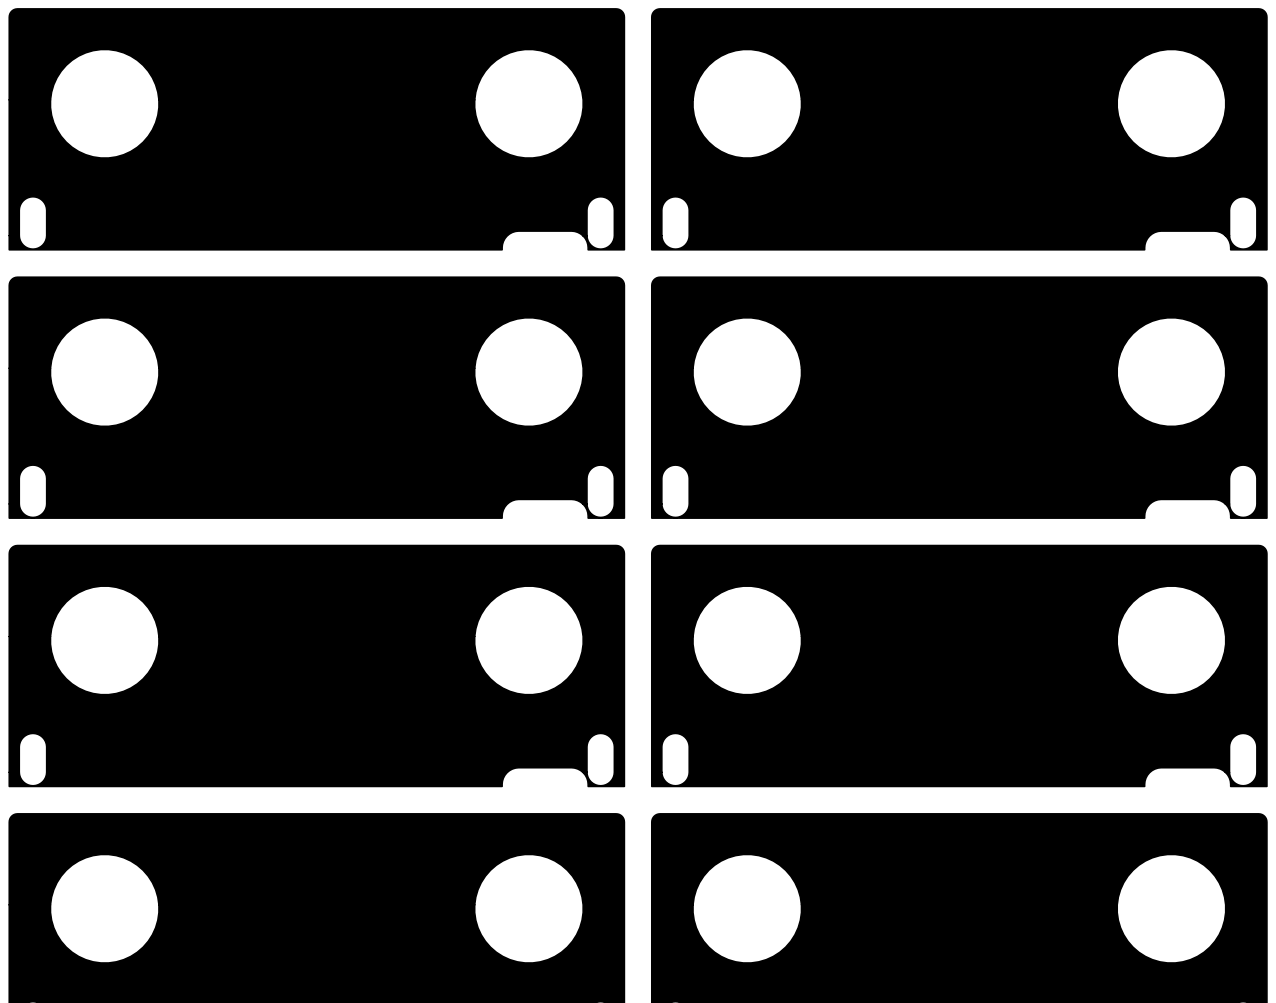
[picture p27: page 1]
