hackzone/cz20-badge/speaker_grill/pdf/panel-F_SilkS.pdf

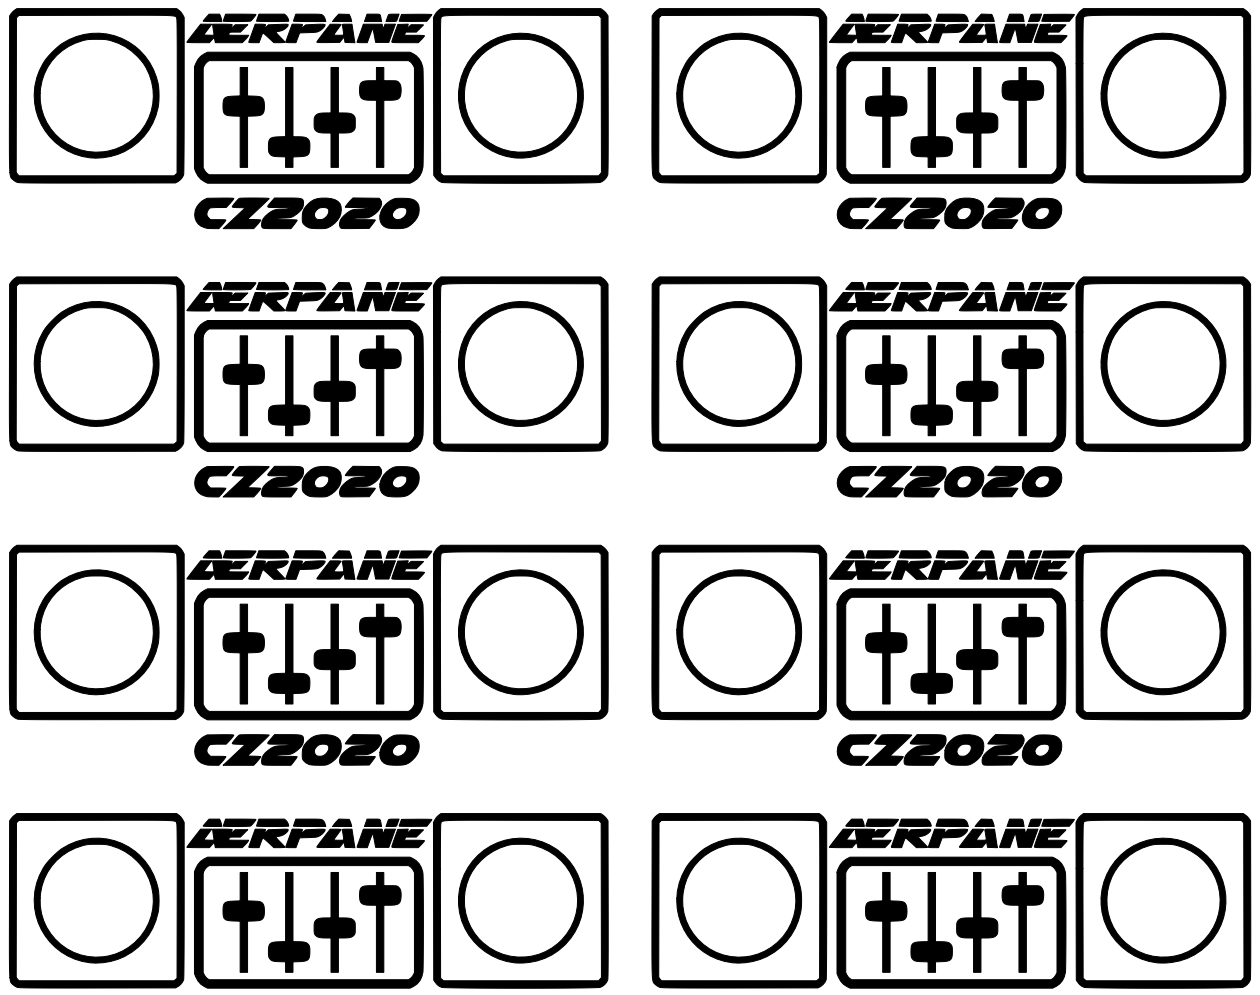
[picture p28: page 1]
