hackzone/cz20-badge/speaker_grill/pdf/speaker_grill-B_CrtYd.pdf

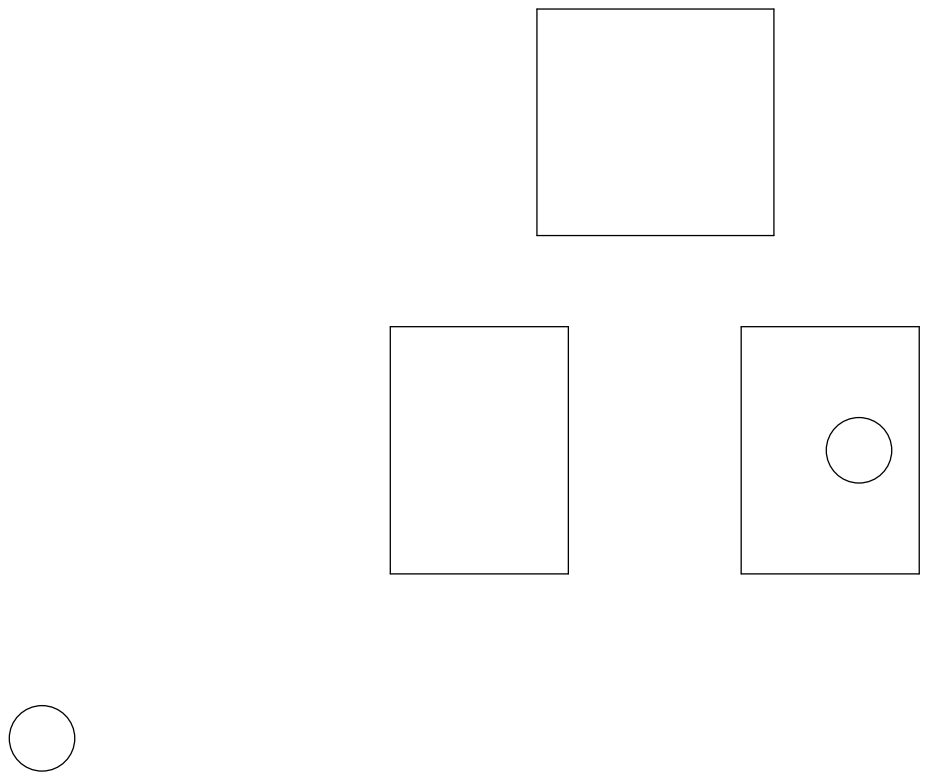
[picture p29: page 1]
