hackzone/cz20-badge/speaker_grill/pdf/speaker_grill-B_Cu.pdf

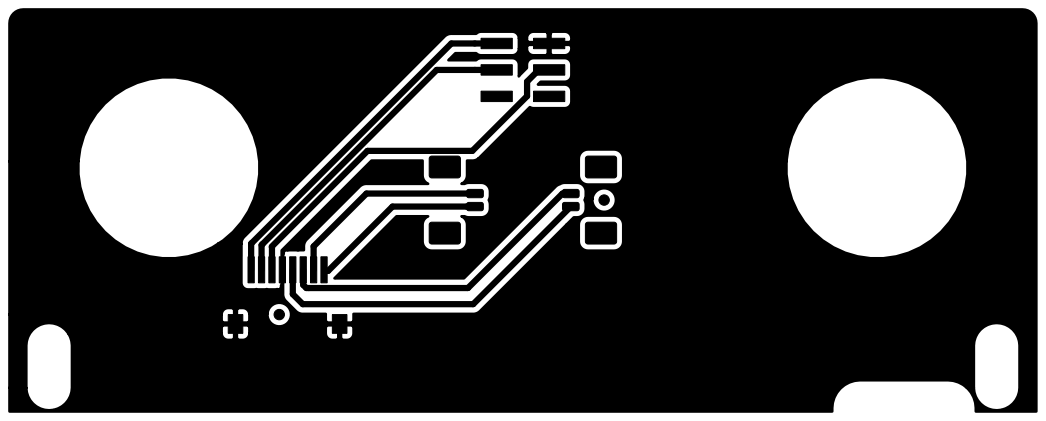
[picture p30: page 1]
