hackzone/cz20-badge/speaker_grill/pdf/speaker_grill-B_Fab.pdf

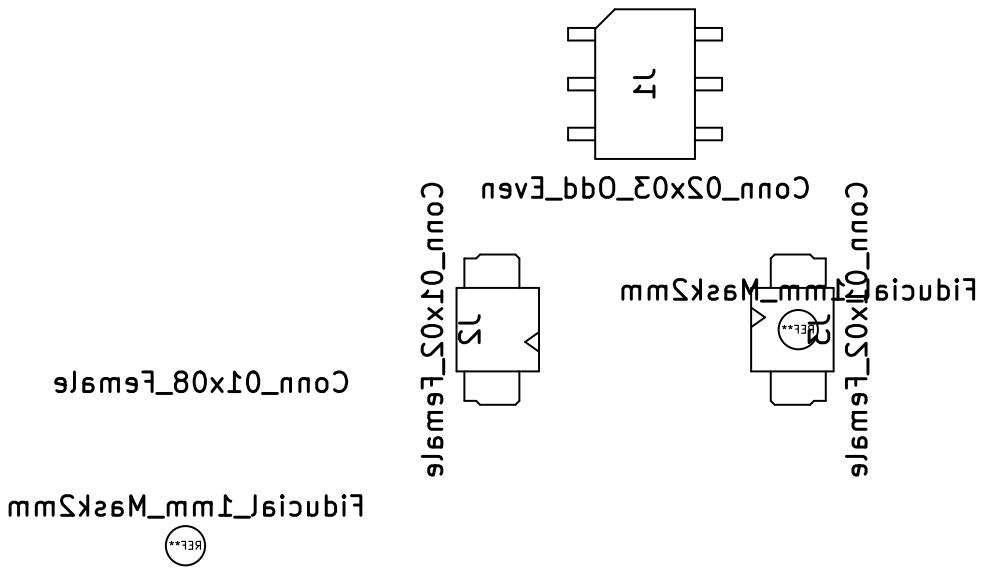
[picture p31: page 1]
