hackzone/cz20-badge/speaker_grill/pdf/speaker_grill-B_Paste.pdf

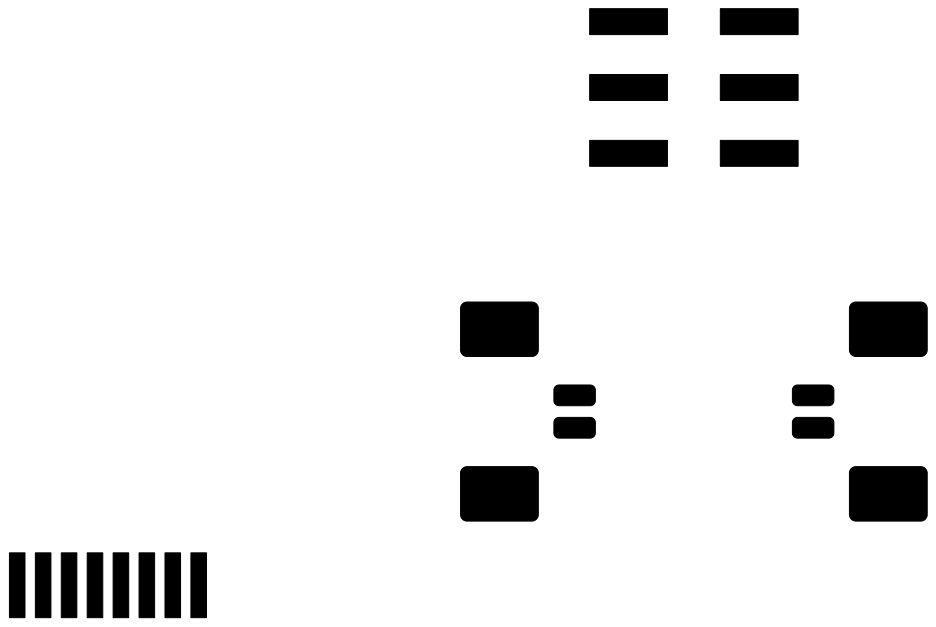
[picture p32: page 1]
