hackzone/cz20-badge/speaker_grill/pdf/speaker_grill-B_SilkS.pdf

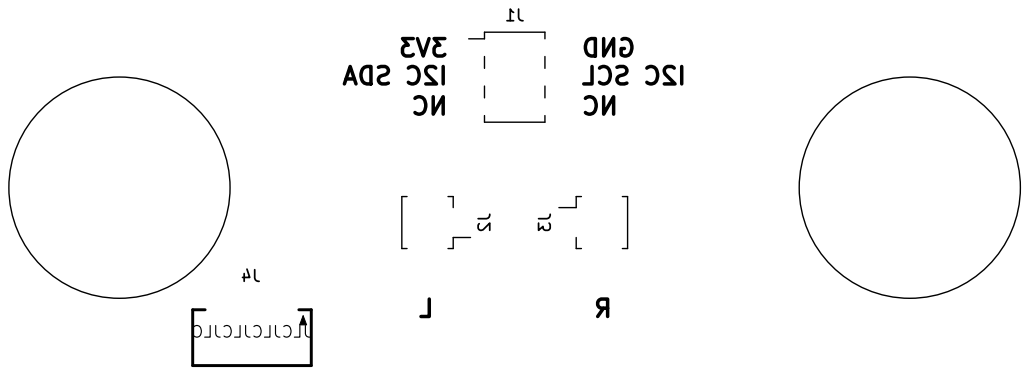
[picture p33: page 1]
