hackzone/cz20-badge/speaker_grill/pdf/speaker_grill-Edge_Cuts.pdf

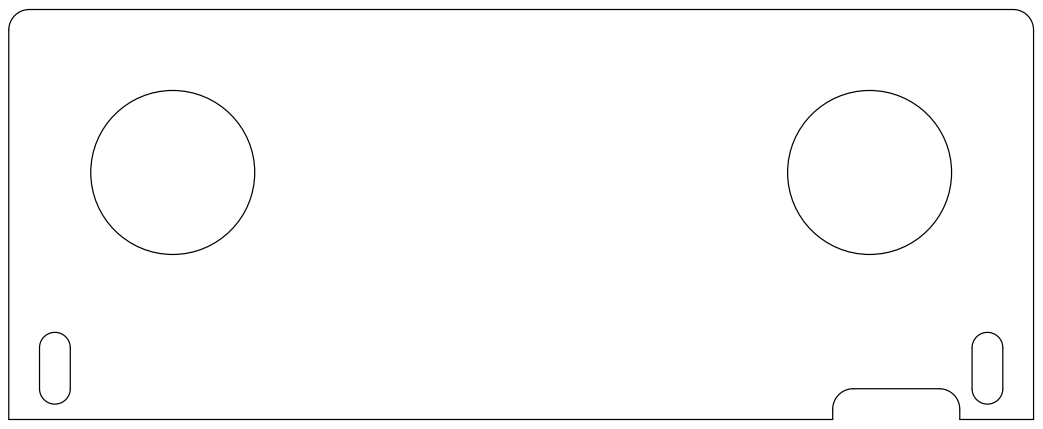
[picture p34: page 1]
