hackzone/cz20-badge/speaker_grill/pdf/speaker_grill-F_Cu.pdf

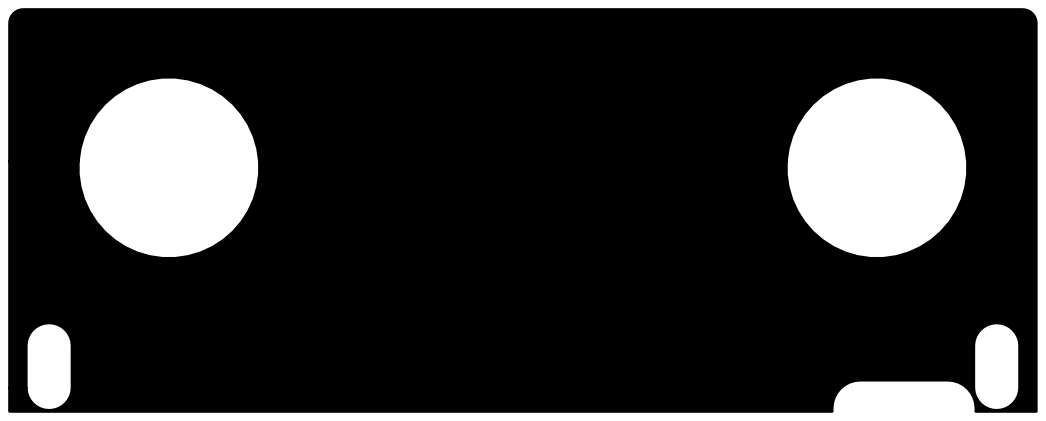
[picture p35: page 1]
