hackzone/cz20-badge/speaker_grill/pdf/speaker_grill-F_SilkS.pdf

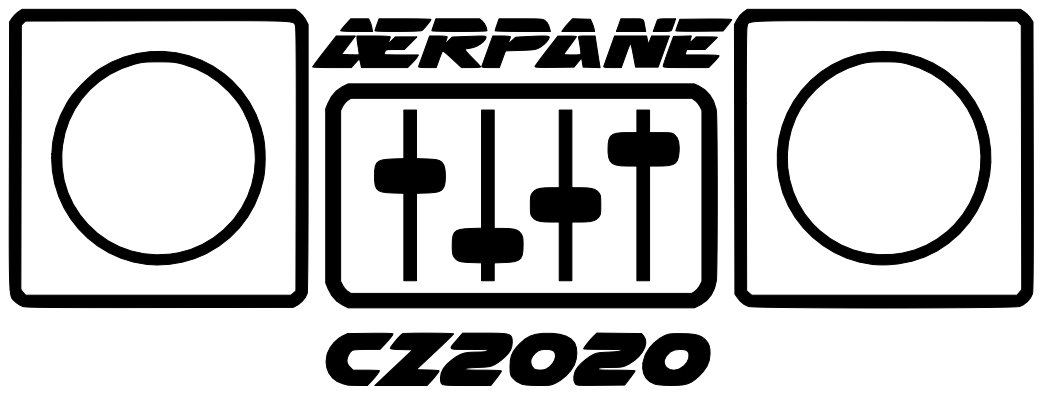
[picture p36: page 1]
