hackzone/cz20-badge/hardware/production_data/v1/pdf/cz-badge-hardware-B_SilkS.pdf

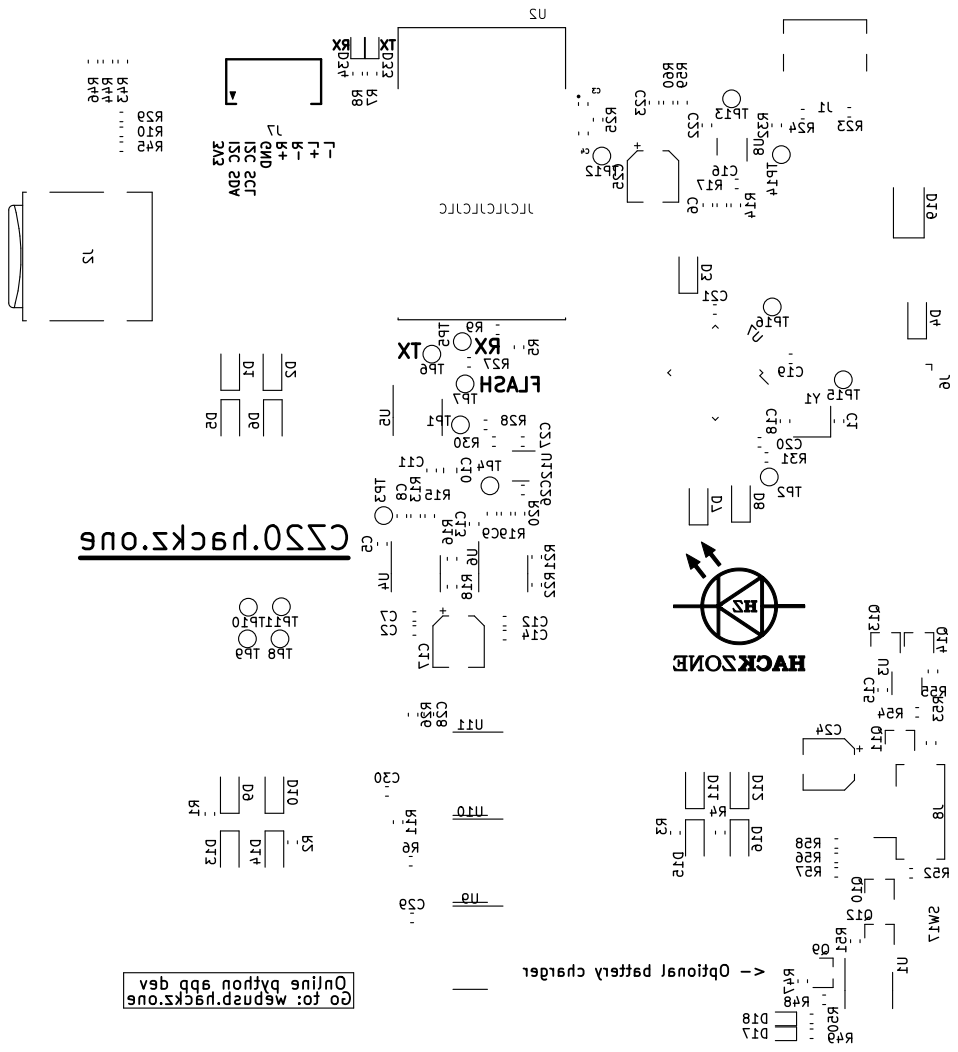
[picture p37: page 1]

FLASH 3V3 I2C SDA I2C SCL GND R+R- L+L- TX RX

<- Optional battery charger Online python app dev Go to: webusb.hackz.one CZ20.hackz.one
