hackzone/cz20-badge/hardware/production_data/v1/pdf/cz-badge-hardware-B_Cu.pdf

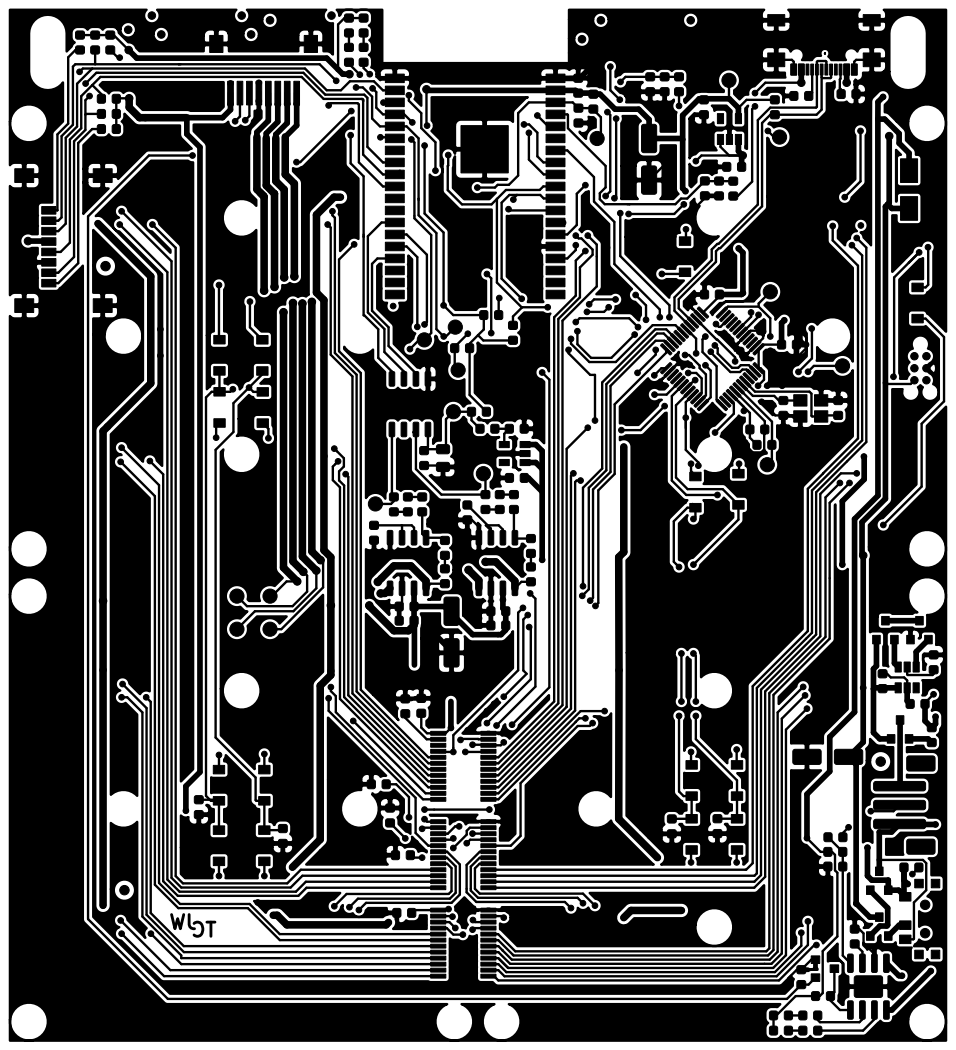
[picture p38: page 1]
