hackzone/cz20-badge/hardware/production_data/v1/pdf/cz-badge-hardware-B_Fab.pdf

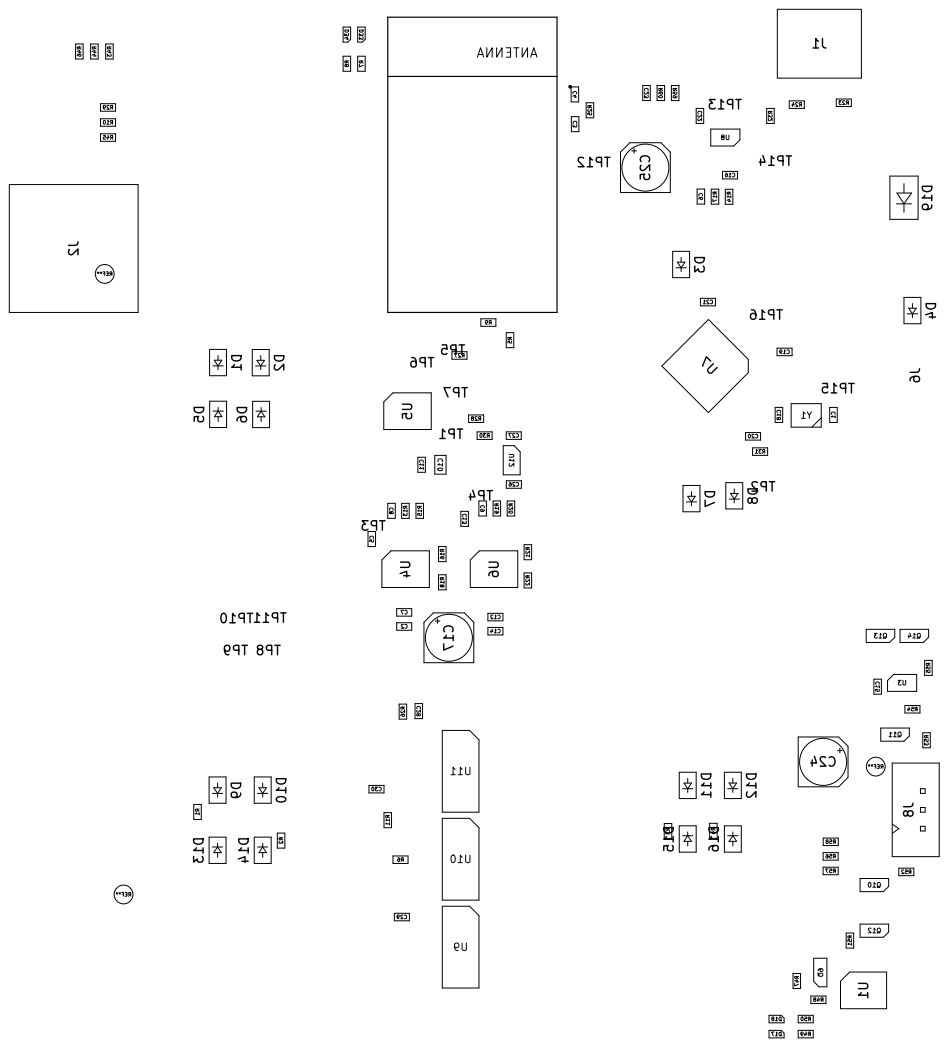
[picture p39: page 1]
