hackzone/cz20-badge/hardware/production_data/v1/pdf/cz-badge-hardware-B_Mask.pdf

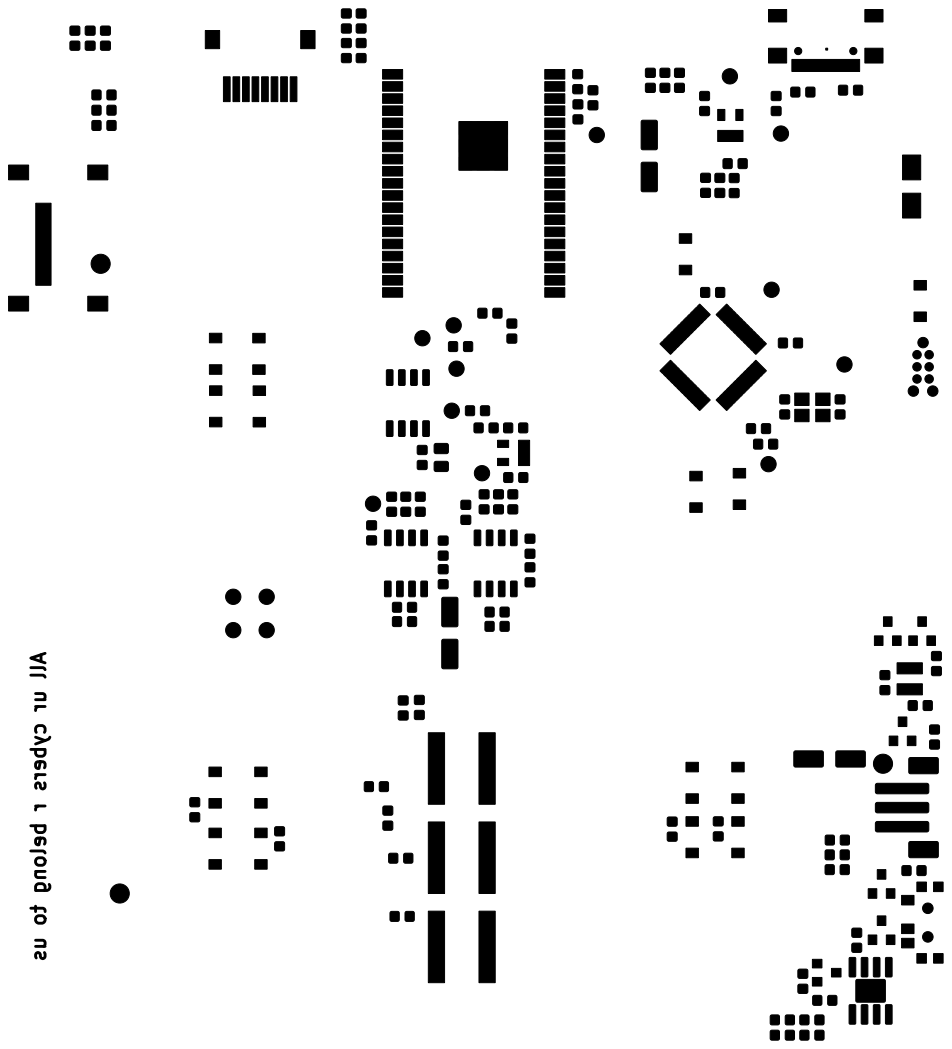
[picture p40: page 1]

All ur cybers r belong to us
