hackzone/cz20-badge/hardware/production_data/v1/pdf/cz-badge-hardware-B_Paste.pdf

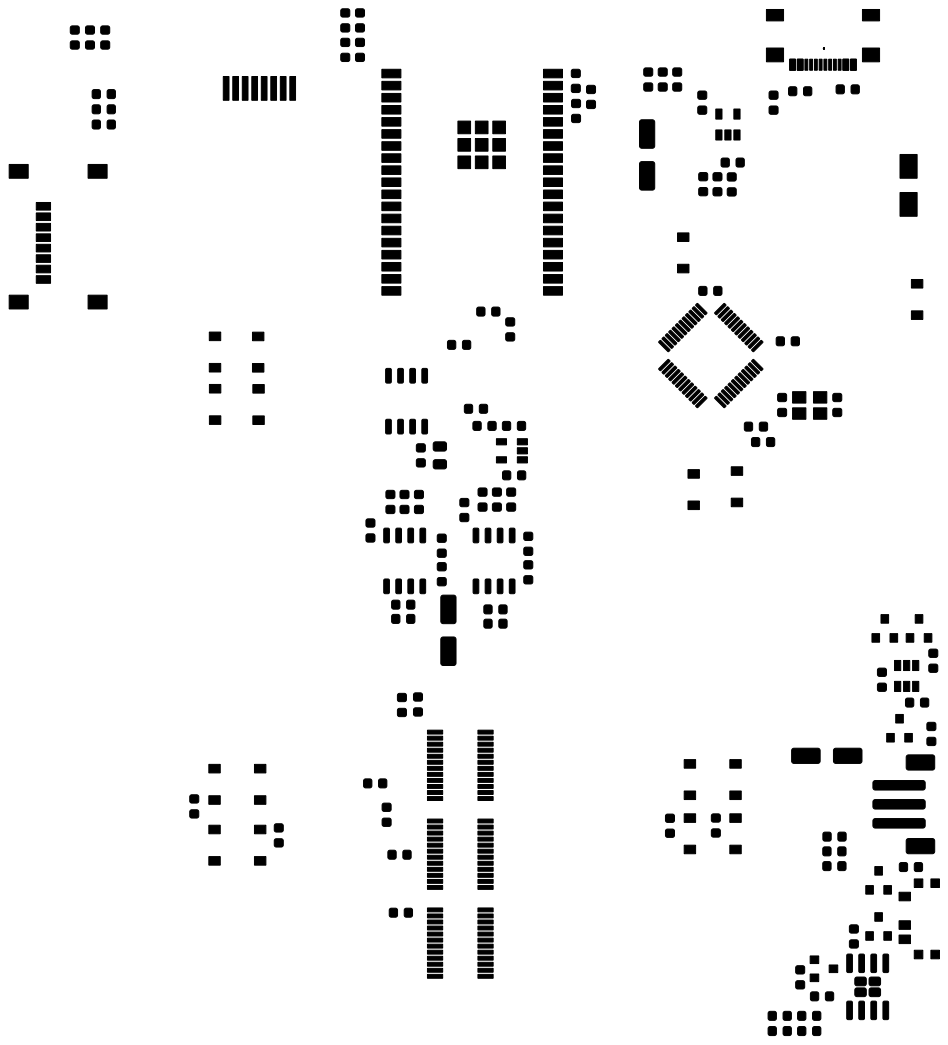
[picture p41: page 1]
