hackzone/cz20-badge/hardware/production_data/v1/pdf/cz-badge-hardware-F_Cu.pdf

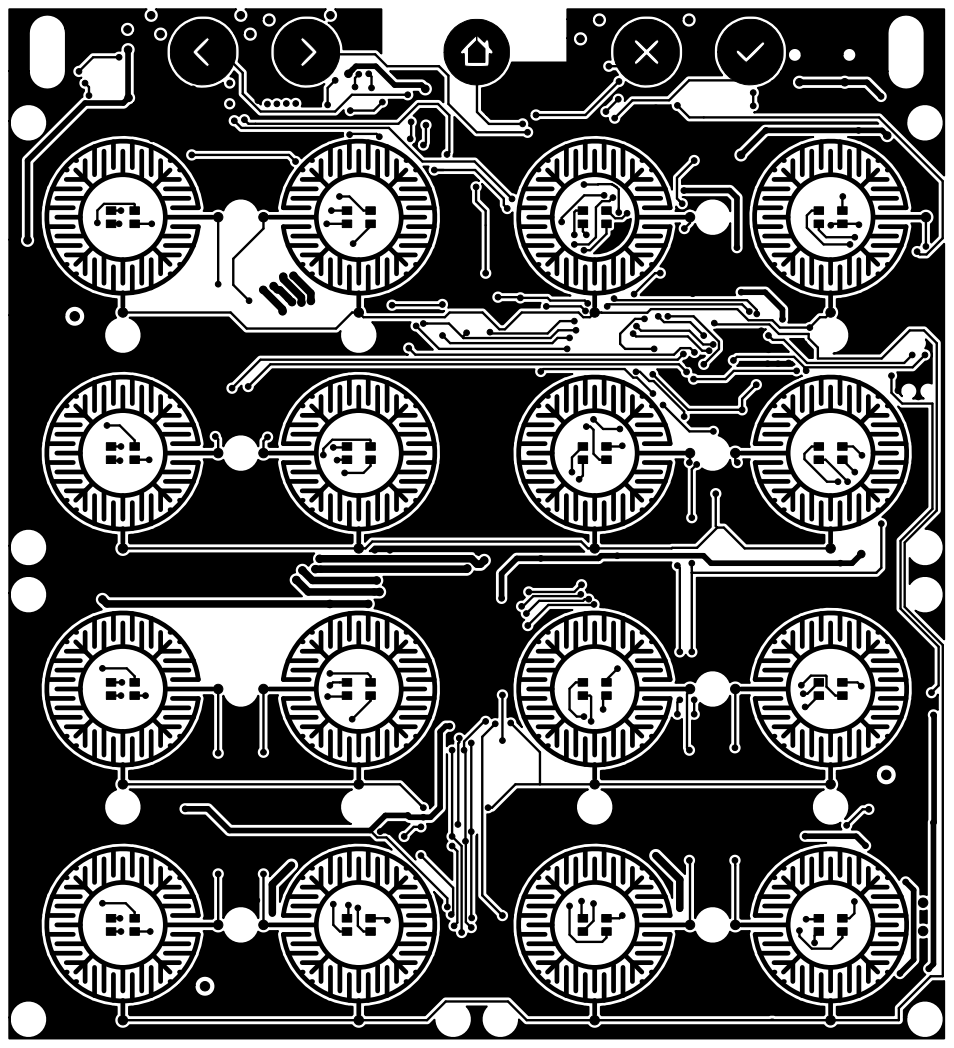
[picture p42: page 1]
