hackzone/cz20-badge/hardware/production_data/v1/pdf/cz-badge-hardware-F_Fab.pdf

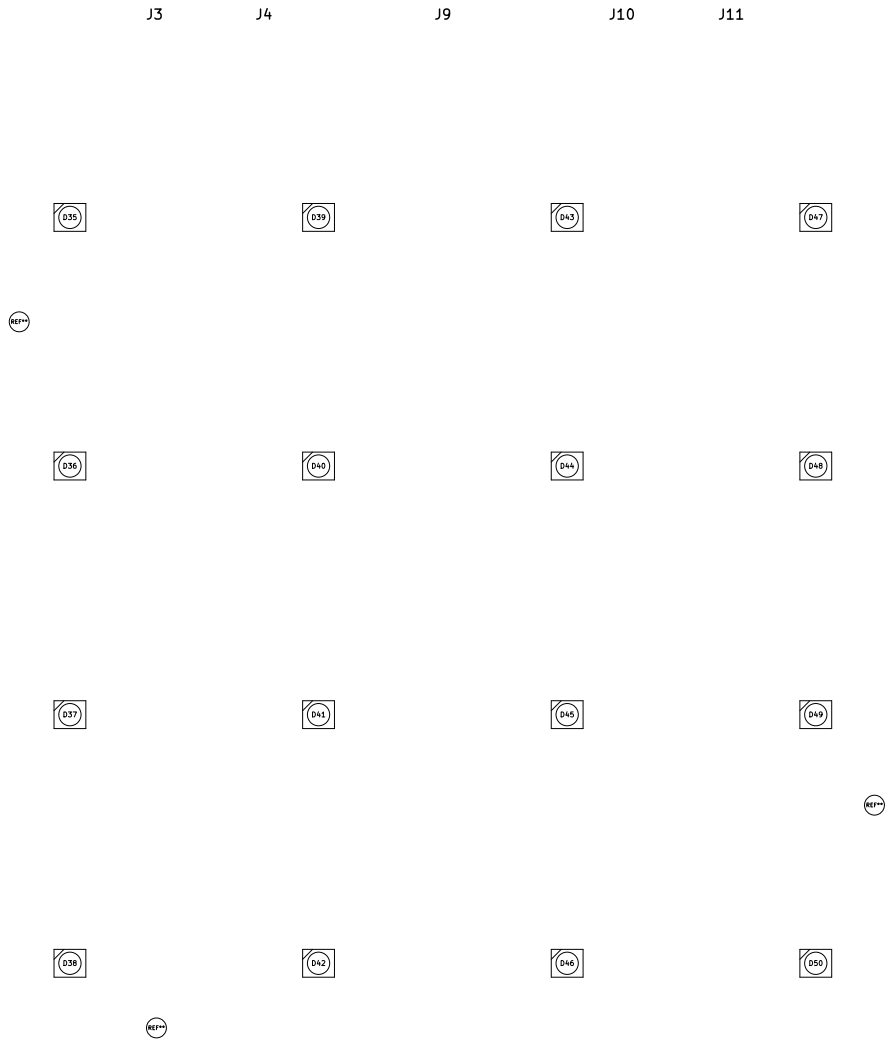
[picture p43: page 1]
