hackzone/cz20-badge/hardware/production_data/v1/pdf/cz-badge-hardware-F_Mask.pdf

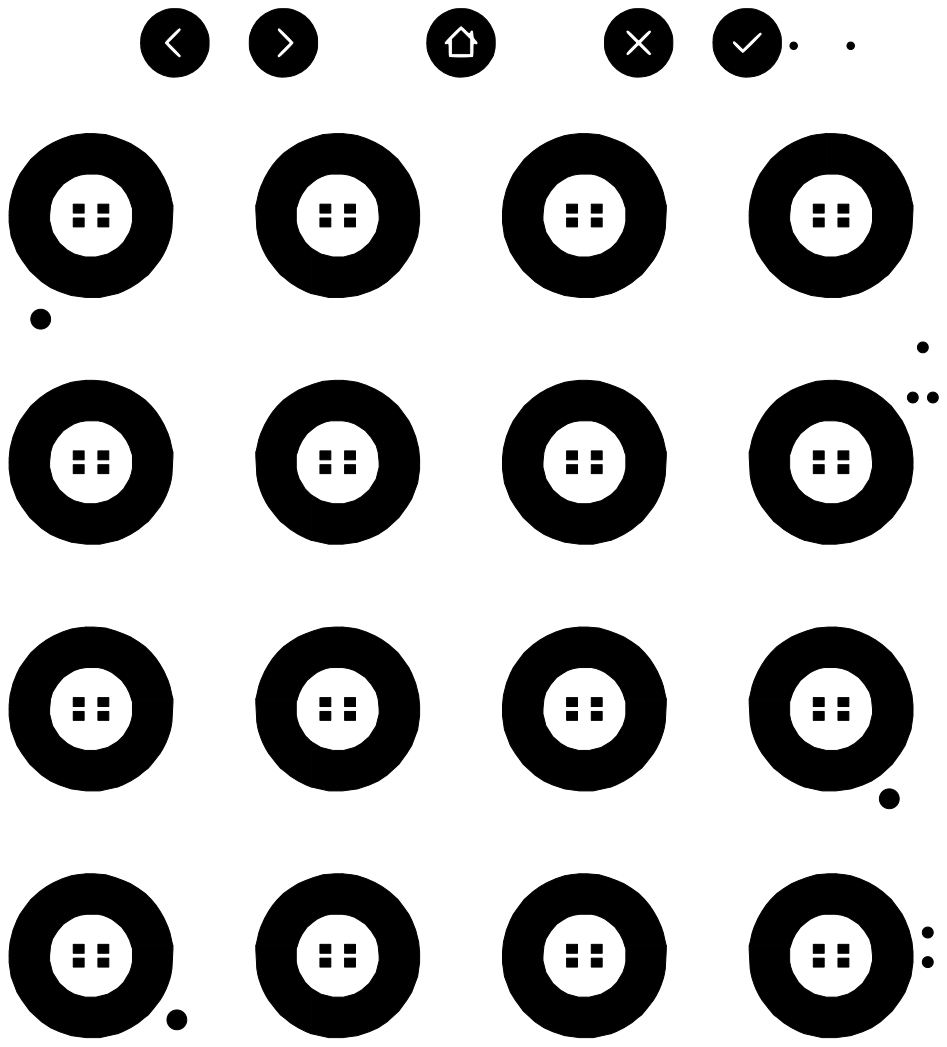
[picture p44: page 1]
