hackzone/cz20-badge/hardware/production_data/v1/pdf/cz-badge-hardware-F_SilkS.pdf

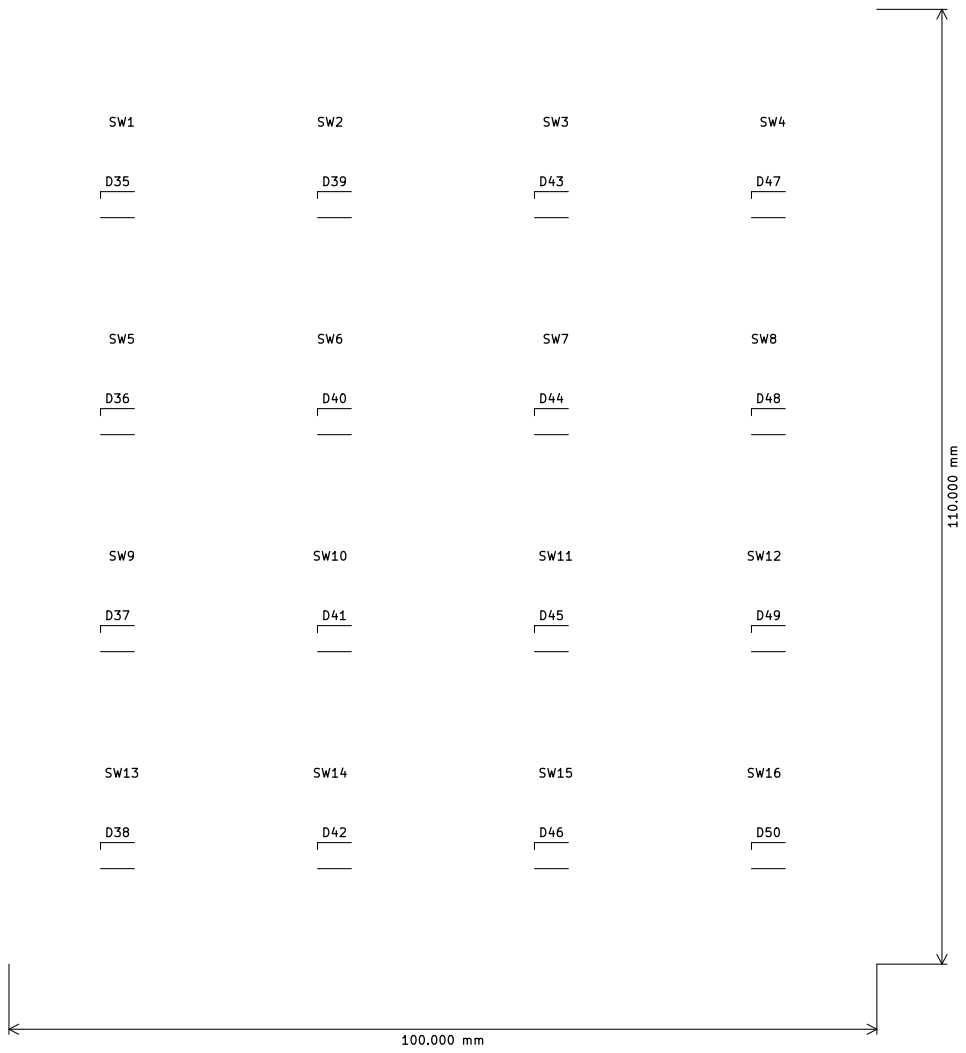
[picture p45: page 1]
