hackzone/cz20-badge/firmware-STM32/Core/Src/main.c

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

/* Includes ------------------------------------------------------------------*/
#include "main.h"

/* USER CODE BEGIN Includes */
#include "tusb.h"
#include "i2c_handler.h"
#include "usb_descriptors.h"
#include "button_driver.h"
#include "led_driver.h"
#include "uart_driver.h"
#include "interrupt_pin.h"
/* USER CODE END Includes */

/* USER CODE BEGIN PD */
#define URL  "webusb.hackz.one"

const tusb_desc_webusb_url_t desc_url =
{
  .bLength         = 3 + sizeof(URL) - 1,
  .bDescriptorType = 3, // WEBUSB URL type
  .bScheme         = 1, // 0: http, 1: https
  .url             = URL
};

static bool web_serial_connected = false;
void webserial_task(void);

/* USER CODE END PD */

I2C_HandleTypeDef hi2c1;

SPI_HandleTypeDef hspi2;

TIM_HandleTypeDef htim1;

UART_HandleTypeDef huart1;
UART_HandleTypeDef huart2;
DMA_HandleTypeDef hdma_usart1_rx;
DMA_HandleTypeDef hdma_usart1_tx;
DMA_HandleTypeDef hdma_usart2_rx;
DMA_HandleTypeDef hdma_usart2_tx;

PCD_HandleTypeDef hpcd_USB_FS;

void SystemClock_Config(void);
static void MX_GPIO_Init(void);
static void MX_DMA_Init(void);
static void MX_I2C1_Init(void);
static void MX_USART1_UART_Init(void);
static void MX_USART2_UART_Init(void);
static void MX_USB_PCD_Init(void);
static void MX_TIM1_Init(void);
static void MX_SPI2_Init(void);
/* USER CODE BEGIN 0 */
enum  {
  BLINK_NOT_MOUNTED = 250,
  BLINK_MOUNTED = 1000,
  BLINK_SUSPENDED = 2500,
};

static uint32_t blink_interval_ms = BLINK_NOT_MOUNTED;
uint32_t last_tick;

void led_task(void);
void usb_device_task(void);
void cdc_task(void);
void hid_task(void);
void midi_task(void);
uint32_t board_millis(void);
/* USER CODE END 0 */

/**
  * @brief  The application entry point.
  * @retval int
  */
int main(void)
{
  /* USER CODE BEGIN 1 */
#ifdef BOOTLOADER_BUILD
	SCB->VTOR = 0x08004000;
	__enable_irq();
#endif
  /* USER CODE END 1 */

  /* MCU Configuration--------------------------------------------------------*/

  /* Reset of all peripherals, Initializes the Flash interface and the Systick. */
  HAL_Init();

  /* Configure the system clock */
  SystemClock_Config();

  /* Initialize all configured peripherals */
  MX_GPIO_Init();
  MX_DMA_Init();
  MX_I2C1_Init();
  MX_USART1_UART_Init();
  MX_USART2_UART_Init();
  MX_USB_PCD_Init();
//  MX_TIM1_Init();
  MX_SPI2_Init();
  /* USER CODE BEGIN 2 */
  HAL_I2C_EnableListen_IT(&hi2c1);
  uart_init();
  tusb_init();

  init_led(&hspi2, &htim1);
  button_init();

  //HAL_TIM_PWM_Start_IT(&htim1, TIM_CHANNEL_1);
  /* USER CODE END 2 */

  /* Infinite loop */
  /* USER CODE BEGIN WHILE */
  while (1)
  {

	  	tud_task(); // tinyusb device task
		#if CFG_TUD_CDC
				cdc_task();
		#endif

		#if CFG_TUD_HID
				hid_task();
		#endif

		#if CFG_TUD_MIDI
				midi_task();
        #endif

        vid_pid_task();

		webusb_task();

		button_task();

		i2c_watchdog(&hi2c1);

		if(last_tick != HAL_GetTick()) {
			last_tick = HAL_GetTick();
			if (UART_SERIAL.Instance->SR & UART_FLAG_IDLE && UART_SERIAL.hdmarx->State == HAL_DMA_STATE_BUSY) /* if Idle flag is set */
			{
				volatile uint32_t tmp; /* Must be volatile to prevent optimizations */
				tmp = UART_SERIAL.Instance->SR; /* Read status register */
				tmp = UART_SERIAL.Instance->DR; /* Read data register */ //This two reads clears the IDLE Flag
				UNUSED(tmp);

				uint32_t cndtr = UART_SERIAL.hdmarx->Instance->CNDTR;
				if(cndtr < 256) {
					HAL_UART_AbortReceive(&UART_SERIAL);
					UART_Early_Exit(&UART_SERIAL, cndtr);
				}
			}

			if(UART_SERIAL.hdmarx->State == HAL_DMA_STATE_READY) {
				UART_Reset();
			}

			if (UART_WEBUSB.Instance->SR & UART_FLAG_IDLE && UART_WEBUSB.hdmarx->State == HAL_DMA_STATE_BUSY) /* if Idle flag is set */
			{
				volatile uint32_t tmp; /* Must be volatile to prevent optimizations */
				tmp = UART_WEBUSB.Instance->SR; /* Read status register */
				tmp = UART_WEBUSB.Instance->DR; /* Read data register */ //This two reads clears the IDLE Flag
				UNUSED(tmp);

				uint32_t cndtr = UART_WEBUSB.hdmarx->Instance->CNDTR;
				if(cndtr < 256) {
					HAL_UART_AbortReceive(&UART_WEBUSB);
					UART_Early_Exit(&UART_WEBUSB, cndtr);
				}
			}

			if(UART_WEBUSB.hdmarx->State == HAL_DMA_STATE_READY) {
				WebUSB_Reset();
			}
		}
    /* USER CODE END WHILE */

    /* USER CODE BEGIN 3 */
  }
  /* USER CODE END 3 */
}

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
/* USER CODE BEGIN 4 */
// Invoked when device is mounted
void tud_mount_cb(void)
{
  blink_interval_ms = BLINK_MOUNTED;
}

// Invoked when device is unmounted
void tud_umount_cb(void)
{
  blink_interval_ms = BLINK_NOT_MOUNTED;
}

// Invoked when usb bus is suspended
// remote_wakeup_en : if host allow us  to perform remote wakeup
// Within 7ms, device must draw an average of current less than 2.5 mA from bus
void tud_suspend_cb(bool remote_wakeup_en)
{
  (void) remote_wakeup_en;
  blink_interval_ms = BLINK_SUSPENDED;
}

// Invoked when usb bus is resumed
void tud_resume_cb(void)
{
  blink_interval_ms = BLINK_MOUNTED;
}


//--------------------------------------------------------------------+
// USB HID
//--------------------------------------------------------------------+
#if CFG_TUD_HID

void hid_task(void)
{
	bool written = false;
	bool should_pause = false;
	uint16_t* button_state = (uint16_t*) getI2CMemory(4);
	uint8_t* hid_keyboard_dirty = (uint8_t*) getI2CMemory(71);
	uint8_t* hid_mouse_dirty = (uint8_t*) getI2CMemory(77);

	// Perform wake-up over USB if any button is pressed
	if ( tud_suspended() && *button_state )
	{
		// Wake up host if we are in suspend mode
		// and REMOTE_WAKEUP feature is enabled by host
		tud_remote_wakeup();
	}

	if(*hid_keyboard_dirty && tud_hid_ready()) {
		uint8_t* key_modifier = (uint8_t*) getI2CMemory(64);
		uint8_t* keycodes = (uint8_t*) getI2CMemory(65); // 6 bytes
		tud_hid_keyboard_report(REPORT_ID_KEYBOARD, *key_modifier, keycodes);

		*hid_keyboard_dirty = 0;
		written = true;
		should_pause = true;
	}

	if(*hid_mouse_dirty && tud_hid_ready()) {
		if(should_pause) {
			// delay a bit before attempt to send mouse report
			HAL_Delay(10);
		}

		int8_t* mouse_data = (int8_t*) getI2CMemory(72);

		// Data in order: buttons bitmask, X, Y, scroll, pan
		tud_hid_mouse_report(REPORT_ID_MOUSE, *((uint8_t*)mouse_data), *(mouse_data+1), *(mouse_data+2), *(mouse_data+3), *(mouse_data+4));
		*hid_mouse_dirty = 0;
		written = true;
	}

	if(written) {
		addInterruptReason(INTERRUPT_REASON_HID_WRITTEN);
		setInterruptPin();
	}
}


// Invoked when received GET_REPORT control request
// Application must fill buffer report's content and return its length.
// Return zero will cause the stack to STALL request
uint16_t tud_hid_get_report_cb(uint8_t report_id, hid_report_type_t report_type, uint8_t* buffer, uint16_t reqlen)
{
  // TODO not Implemented
  (void) report_id;
  (void) report_type;
  (void) buffer;
  (void) reqlen;

  return 0;
}

// Invoked when received SET_REPORT control request or
// received data on OUT endpoint ( Report ID = 0, Type = 0 )
void tud_hid_set_report_cb(uint8_t report_id, hid_report_type_t report_type, uint8_t const* buffer, uint16_t bufsize)
{
  // TODO set LED based on CAPLOCK, NUMLOCK etc...
  (void) report_id;
  (void) report_type;
  (void) buffer;
  (void) bufsize;
}

#endif

//--------------------------------------------------------------------+
// MIDI Task
//--------------------------------------------------------------------+

#if CFG_TUD_MIDI

void midi_task(void)
{
	bool written = false;

	// Check and send MIDI data in any of the 4 data buffers
	for(uint8_t i = 0; i < 4; i++) {
		uint8_t* midi_data = (uint8_t*) getI2CMemory(78 + i * 4);
		uint8_t* dirty_byte = midi_data + 3;

		if(*dirty_byte) {
			tudi_midi_write24(0, *midi_data, *(midi_data+1), *(midi_data+2));
			*dirty_byte = 0;
			written = true;
		}
	}

	if(written) {
		addInterruptReason(INTERRUPT_REASON_MIDI_WRITTEN);
		setInterruptPin();
	}

	if(tud_midi_available()) {
		uint8_t* data = getI2CMemory(95);
		uint8_t* count = getI2CMemory(94);
		*count = tud_midi_read(data, 32);
		addInterruptReason(INTTERUPT_REASON_MIDI_RECEIVED);
		setInterruptPin();
		//Do something with the data here

	}
}


#endif



//--------------------------------------------------------------------+
// USB VID/PID changer task
//--------------------------------------------------------------------+

void vid_pid_task(void)
{
    uint8_t* dirty_byte = (uint8_t*) getI2CMemory(123);

    if(*dirty_byte) {
        uint8_t *vid = (uint8_t *) getI2CMemory(124);
        uint8_t *pid = (uint8_t *) getI2CMemory(126);

        desc_device.idVendor = *vid;
        desc_device.idProduct = *pid;

        *dirty_byte = 0;

        // Trigger a reset on the USB port so we get re-enumerated by the host
        usbd_reset(0);
        tusb_init();
    }
}

//--------------------------------------------------------------------+
// WebUSB use vendor class
//--------------------------------------------------------------------+

// Invoked when received VENDOR control request
bool tud_vendor_control_request_cb(uint8_t rhport, tusb_control_request_t const * request)
{
  switch (request->bRequest)
  {
    case VENDOR_REQUEST_WEBUSB:
      // match vendor request in BOS descriptor
      // Get landing page url
      return tud_control_xfer(rhport, request, (void*) &desc_url, desc_url.bLength);

    case VENDOR_REQUEST_MICROSOFT:
      if ( request->wIndex == 7 )
      {
        // Get Microsoft OS 2.0 compatible descriptor
        uint16_t total_len;
        memcpy(&total_len, desc_ms_os_20+8, 2);

        return tud_control_xfer(rhport, request, (void*) desc_ms_os_20, total_len);
      }else
      {
        return false;
      }

    case 0x22:
      // Webserial simulate the CDC_REQUEST_SET_CONTROL_LINE_STATE (0x22) to
      // connect and disconnect.
      web_serial_connected = (request->wValue != 0);

      // Always lit LED if connected
      if ( web_serial_connected )
      {
        //board_led_write(true);
        //blink_interval_ms = BLINK_ALWAYS_ON;


      }else
      {
        blink_interval_ms = BLINK_MOUNTED;
      }

      // response with status OK
      return tud_control_status(rhport, request);

    default:
      // stall unknown request
      return false;
  }

  return true;
}

// Invoked when DATA Stage of VENDOR's request is complete
bool tud_vendor_control_complete_cb(uint8_t rhport, tusb_control_request_t const * request)
{
  (void) rhport;
  (void) request;

  // nothing to do
  return true;
}

uint32_t board_millis(void)
{
  return HAL_GetTick();
}

/* USER CODE END 4 */
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
