hackzone/cz20-badge/firmware-STM32/firmware-STM32.ioc

Mcu.UserName=STM32F103C8Tx
PB13.Signal=SPI2_SCK
PB15.Signal=SPI2_MOSI
PD1-OSC_OUT.Signal=RCC_OSC_OUT
PA12.Signal=USB_DP
PB6.Signal=I2C1_SCL
PB2.Signal=GPIO_Output
PB7.Signal=I2C1_SDA
PB1.Signal=GPIO_Output
PA6.Signal=GPIO_Input
PA10.Signal=USART1_RX
PA3.Signal=USART2_RX
PC13-TAMPER-RTC.Signal=GPIO_Output
PD0-OSC_IN.Signal=RCC_OSC_IN
PC14-OSC32_IN.Signal=GPIO_Output
PA0-WKUP.Signal=GPIO_Input
PA13.Signal=SYS_JTMS-SWDIO
PA9.Signal=USART1_TX
PB14.Signal=GPIO_Output
PA5.Signal=GPIO_Input
PA2.Signal=USART2_TX
PB3.Signal=GPIO_Output
PA4.Signal=GPIO_Input
PA11.Signal=USB_DM
PA14.Signal=SYS_JTCK-SWCLK
PB0.Signal=GPIO_Output
PB12.Signal=GPIO_Output
PA7.Signal=GPIO_Input
