hackzone/cz20-badge/firmware-STM32/Core/Inc/button_driver.h

/*
 * button_driver.h
 *
 *  Created on: Mar 16, 2020
 *      Author: joris
 */

#ifndef INC_BUTTON_DRIVER_H_
#define INC_BUTTON_DRIVER_H_

#include "main.h"
#include "stm32f1xx_hal.h"

void button_init();
void button_task();

#endif /* INC_BUTTON_DRIVER_H_ */
