hackzone/cz20-badge/firmware-STM32/Core/Inc/interrupt_pin.h

/*
 * interrupt_pin.h
 *
 *  Created on: 2 Apr 2020
 *      Author: tom
 */

#ifndef INC_INTERRUPT_PIN_H_
#define INC_INTERRUPT_PIN_H_

#include "stm32f1xx_hal.h"

#define INTERRUPT_REASON_GENERAL 1
#define INTERRUPT_REASON_BUTTON 2
#define INTERRUPT_REASON_MIDI 4
#define INTERRUPT_REASON_HID_WRITTEN 8
#define INTERRUPT_REASON_MIDI_WRITTEN 16
#define INTTERUPT_REASON_MIDI_RECEIVED 32

void setInterruptPin();
void resetInterruptPin();
void addInterruptReason(uint8_t reason);
void clearInterruptReason();

#endif /* INC_INTERRUPT_PIN_H_ */
