hackzone/cz20-badge/(commit log)

2020-01-20 Initial commit of proto v2
    [audio.sch, buttons.sch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]
2020-02-03 Fixed diode being too close to standoff
    [cz-badge-hardware.kicad_pcb]
2020-02-03 Added ESP32 firmware submodule
2020-02-03 Renamed hardware folder
    [audio.sch, buttons.sch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]
2020-02-03 Renamed ESP32 firmware submodule
2020-02-03 Added Joris' CDC test for STM32
2020-02-05 Dumb leds and stm32 magic
    [audio.sch, buttons.sch, cz-badge-hardware.kicad_pcb, cz-badge-hardware.sch]
2020-02-05 Updated silkscreen
    [cz-badge-hardware.kicad_pcb]
2020-02-05 Added lcsc partnumbers
    [audio.sch, buttons.sch, cz-badge-hardware.sch, led_matrix.sch, stm32.sch]
2020-02-05 Added bottom ground pout
    [cz-badge-hardware.kicad_pcb]
2020-02-05 added mirror key button
2020-02-11 Added battery circuit
    [Power.sch, audio.sch, buttons.sch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]
2020-02-13 Connected charge enable, moved led away from holes
    [cz-badge-hardware.kicad_pcb, cz-badge-hardware.sch]
2020-02-22 Wrover fp
    [Power.sch, audio.sch, cz-badge-hardware.kicad_pcb, cz-badge-hardware.sch, stm32.sch]
2020-02-22 Moved designators for readability
    [cz-badge-hardware.kicad_pcb]
2020-03-15 Fixed polarity battery protection
    [Power.sch, cz-badge-hardware.kicad_pcb]
2020-03-15 Revert "Fixed polarity battery protection"
    This reverts commit d596a3d4647cf381d02caddfcfeb8f064578e0bb.
    [Power.sch, cz-badge-hardware.kicad_pcb]
2020-03-16 Some small changes to the fabrication layer (for easier documentation whilst hand placing)
    [cz-badge-hardware.kicad_pcb]
2020-03-16 Updated upstream ESP32 firmware
2020-03-18 Added Joris' STM32 firmware base
2020-03-18 Fixed button drive
2020-03-18 Added dma based cdc to uart bridge
2020-03-18 Fixed an tweaked button driver
    [button_driver.c]
2020-03-18 WIP v4 proto
    [Power.sch, audio.sch, buttons.sch, cz-badge-hardware.kicad_pcb, cz-badge-hardware.sch, led_matrix.sch, stm32.sch]
2020-03-18 Updated resistor to 1.5k according to stm datasheet
    [Power.sch, audio.sch, buttons.sch, cz-badge-hardware.sch, led_matrix.sch, stm32.sch]
2020-03-18 Added more touch buttons
    [cz-badge-hardware.kicad_pcb, cz-badge-hardware.sch]
2020-03-18 Added n-fets to LEDs
    [Power.sch, cz-badge-hardware.kicad_pcb, cz-badge-hardware.sch, stm32.sch]
2020-03-19 Changed connectors to smd and added powerswitch
    [Power.sch, cz-badge-hardware.kicad_pcb, cz-badge-hardware.sch, stm32.sch]
2020-03-19 Updated design rules
    [cz-badge-hardware.kicad_pcb]
2020-03-19 Moved top silkscreen
    [cz-badge-hardware.kicad_pcb]
2020-03-19 Moved mounting slits 1.5mm further away from the silicone keypad
    [cz-badge-hardware.kicad_pcb]
2020-03-19 Production data rev4
    [Power.sch, audio.sch, cz-badge-hardware.csv, cz-badge-hardware.kicad_pcb, cz-badge-hardware.sch, stm32.sch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]
2020-03-21 Changed oscillator to 16MHz
    [firmware-STM32.ioc, main.c]
2020-03-21 Updated production files: - vias in 8-pin female header - fixed some text elements - added testpoint for FLASH
    [Power.sch, audio.sch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]
2020-03-21 Finished USB UART support, including ESP32 reset+flash logic w/ DTR+RTS
    [main.c, uart_driver.c]
2020-03-22 Moved i2s BCK and ~charge_enable to 21+22 because 16+17 are in use for PSRAM on WROVER
    [cz-badge-hardware.sch]
2020-04-01 LED support for v4 (breaks v3)
2020-04-01 Working on i2c driver
2020-04-02 Functional i2c bridge for keypad, LEDs, USB HID, and USB MIDI
2020-04-04 Latest ESP32 FW
2020-04-04 Updated ESP32 FW
2020-04-06 Framebuffer driver for STM32 i2c display
2020-04-07 Updated PCB to move i2s and CE away from pin 16/17 used by PSRAM
    [cz-badge-hardware.kicad_pcb]
2020-04-07 Rev5 schematic changes and pcb cleanup
    [Power.sch, audio.sch, cz-badge-hardware.kicad_pcb, cz-badge-hardware.sch, led_matrix.sch, stm32.sch]
2020-04-07 Major routing of the led matrix done
    [audio.sch, cz-badge-hardware.kicad_pcb, led_matrix.sch]
2020-04-07 Routed VCC to all leds
    [cz-badge-hardware.kicad_pcb]
2020-04-08 Finished routing rev5
    [audio.sch, cz-badge-hardware.kicad_pcb, stm32.sch]
2020-04-08 Updated top silkscreen to v5
    [cz-badge-hardware.kicad_pcb]
2020-04-19 Added webusb to uart translation layer
2020-04-19 Fixed webusb not sending commands
    [firmware-STM32.ioc, main.c, uart_driver.c]
2020-04-19 Now able to request file directory from esp32
2020-04-25 UART changes
    [cz-badge-hardware.kicad_pcb, cz-badge-hardware.sch, stm32.sch]
2020-04-26 Added flowcontrol for uart
2020-04-26 Added make files/folder and cut/copy/paste file support
2020-04-26 Forward esp32 firmware
2020-04-27 Moved touch pin
    [cz-badge-hardware.kicad_pcb, cz-badge-hardware.sch]
2020-04-29 Fixed interrupt pin clearing i2c reason mask, increased LED interrupt priority, added interrupts on finishing HID or MIDI writes, updated to latest ESP firmware
    [firmware-STM32.ioc, i2c_handler.c, interrupt_pin.h, main.c]
2020-04-29 Added FFC connector
    [cz-badge-hardware.kicad_pcb, cz-badge-hardware.sch]
2020-05-02 Filled in rext value
    [led_matrix.sch]
2020-05-04 Added touch button icons
    [cz-badge-hardware.kicad_pcb, cz-badge-hardware.sch]
2020-05-04 Revert "Added touch button icons"
    This reverts commit 51976bd286088c9a3bd53c6ca08a0e32d9680795.
    [cz-badge-hardware.kicad_pcb, cz-badge-hardware.sch]
2020-05-04 Added touchbutton icons
    [cz-badge-hardware.kicad_pcb, cz-badge-hardware.sch]
2020-05-04 Fixed BOM lines
    [Power.sch, audio.sch, cz-badge-hardware.kicad_pcb, led_matrix.sch, stm32.sch]
2020-05-05 Generated rev5 production data
    [cz-badge-hardware-B_Cu.gbl, cz-badge-hardware-B_Fab.gbr, cz-badge-hardware-B_Mask.gbs, cz-badge-hardware-B_Paste.gbp, cz-badge-hardware-B_SilkS.gbo, cz-badge-hardware-Edge_Cuts.gm1, cz-badge-hardware-F_Cu.gtl, cz-badge-hardware-F_Fab.gbr]
2020-05-15 WIP new LED driver
2020-05-16 Fixed latching of LED driver
    [led_driver.c]
2020-05-16 Fixed debug state of LEDs
    [led_driver.c]
2020-05-16 Working led drive
2020-05-16 18MHz spi clk
2020-05-16 WIP LED driver
2020-05-16 Fixed led driver
2020-05-16 Truely fixed led driver
    [i2c_handler.c, led_driver.c, main.c]
2020-05-16 i2c watchdog to reset bus in case of a fault
    [i2c_handler.c, i2c_handler.h, main.c]
2020-05-17 Updated button driver with new pinout
2020-05-17 forward esp32
2020-05-17 Fixed 3.3V rail to led drivers. Switched to 2A diode
    [Power.sch, cz-badge-hardware.kicad_pcb, led_matrix.sch]
2020-05-17 Added dnp for battery charge circuit
    [Power.sch]
2020-05-17 Value cleanup
    [Power.sch, audio.sch]
2020-05-17 Few more dnp
    [audio.sch, cz-badge-hardware.sch]
2020-05-22 Fixed STM32 I2C reset blocking USB UART
    [i2c_handler.c, i2c_handler.h]
2020-05-22 Changed STM32 LED driver to intialise with a clear screen, instead of full white
2020-05-23 Write midi in data to i2c memory
2020-05-23 Speaker frontplate pcb design
    [speaker_grill.kicad_pcb, speaker_grill.sch]
2020-05-23 Updated lcsc part numbers
    [cz-badge-hardware.sch, led_matrix.sch]
2020-05-23 Hinge stl
    [hinge.scad, hinge.stl]
2020-05-25 Added testpoints to audio lines
    [Power.sch, audio.sch, cz-badge-hardware.kicad_pcb, cz-badge-hardware.sch]
2020-05-25 Switch to tag connect for programming header
    [cz-badge-hardware.kicad_pcb, stm32.sch]
2020-05-25 Added 5V power input to programmer header
    [cz-badge-hardware.kicad_pcb, stm32.sch]
2020-05-25 Decrease usb hole height
    [speaker_grill.kicad_pcb]
2020-05-25 Silkscreen and extra testpoints
    [cz-badge-hardware.kicad_pcb, cz-badge-hardware.sch]
2020-05-25 More silkscreen work
    [cz-badge-hardware.kicad_pcb]
2020-05-25 Final layout changes
    [cz-badge-hardware.kicad_pcb, stm32.sch]
2020-05-25 Small silkscreen changes
    [cz-badge-hardware.kicad_pcb]
2020-05-25 More silkscreen changes
    [cz-badge-hardware.kicad_pcb]
2020-05-25 Fixed pad in touch pad
    [cz-badge-hardware.kicad_pcb]
2020-05-28 Added more of the button functionality in the file explorer
2020-05-30 ESP32 firmware forward
2020-05-30 i2c highest prio
2020-05-31 Implemented app store filters
2020-05-31 ESP32 firmware in CI, added README (#3)
    * Added npm build and lint workflow
    * Some node versions
    * Create esp32.yml
    Build firmware-ESP32
    * Install curses, added README
    * Added flex
    * Added bison
2020-05-31 Gerber files for v1
    [cz-badge-hardware-B_CrtYd.gbr, cz-badge-hardware-B_Cu.gbl, cz-badge-hardware-B_Fab.gbr, cz-badge-hardware-B_Mask.gbs, cz-badge-hardware-B_Paste.gbp, cz-badge-hardware-B_SilkS.gbo, cz-badge-hardware-Edge_Cuts.gm1, cz-badge-hardware-F_CrtYd.gbr]
2020-06-01 Added fiducials to top and bottom PCBs
    [cz-badge-hardware-B_CrtYd.gbr, cz-badge-hardware-B_Cu.gbr, cz-badge-hardware-B_Fab.gbr, cz-badge-hardware-B_Mask.gbr, cz-badge-hardware-B_Paste.gbr, cz-badge-hardware-B_SilkS.gbr, cz-badge-hardware-Edge_Cuts.gbr, cz-badge-hardware-F_CrtYd.gbr]
2020-06-01 Custom panel
    [panel.kicad_pcb]
2020-06-01 Cleanup v1
    [cz-badge-hardware-B_Cu.gbl, cz-badge-hardware-B_Mask.gbs, cz-badge-hardware-B_Paste.gbp, cz-badge-hardware-B_SilkS.gbo, cz-badge-hardware-Edge_Cuts.gm1, cz-badge-hardware-F_Cu.gtl, cz-badge-hardware-F_Mask.gts, cz-badge-hardware-F_Paste.gtp]
2020-06-01 Added v1 speaker panel gerber zip
2020-06-01 Updated speaker panel gerbers for JLC
    [panel-B_CrtYd.gbr, panel-B_Cu.gbr, panel-B_Fab.gbr, panel-B_Mask.gbr, panel-B_Paste.gbr, panel-B_SilkS.gbr, panel-Cmts_User.gbr, panel-Edge_Cuts.gbr]
2020-06-01 firmware-STM32 CI (#4)
    * Let's see if we can get that toolchain in the CI
    * TODO
    * CMake Magic
    * CMake Magic part two
    * Remove CMakeCache.txt
    * Set some ENV settings for compiler
    * Added some env stuff in a different way
    * Added gcc-arm-none-eabi
    * Forgotten build-essential
    * AVR libc
    * More headers
    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
2020-06-02 Build bootloader too (#5)
    * Added more to README
    * CMake for bootloader
    * Minor clean up, oversized
    * 64K flash
    * Build both STM32 targets
    * Added another badge
    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
2020-06-03 Updated speaker grill to have F.Mask and drill holes because JLC employees are brainless hive mind drones that are unable to comprehend written language
    [speaker_grill.kicad_pcb]
2020-06-04 Tweaked button grid to be responsive
2020-06-05 Fixed pagination of app buttons, implemented removing apps by selecting "No app" in the dropdown
2020-06-09 Made a leaner version of the PCB hinge design
    [hinge_light.scad, hinge_light.stl]
2020-06-13 Light version of the hinge
    [hinge_light.scad, hinge_light.stl]
2020-06-13 Final production files v1 (added centroids)
    [CZ20_badge_BoM.xlsx, cz-badge-hardware.kicad_pcb, speaker_grill.csv, speaker_grill.kicad_pcb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]
2020-06-20 Added apm32f1 openocd config
    [apm32f1x.cfg]
2020-06-20 Added build and flash scripts for STM firmware (requires ST-Link V2)
    [apm32f1x.cfg]
2020-06-20 Updated hinge designs to what was printed
    [hinge_light.scad, hinge_light_w_base.stl]
2020-06-20 Updated production files to what was ordered
    [cz-badge-hardware.kicad_pcb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]
2020-07-01 Updated WebUSB domains, added batch flashing script for flashing STM32s
2020-07-05 Added flashing jig model
    [CZ20_jig.scad, CZ20_jig.stl]
2020-07-18 Fixed bug where saving a file would deselect the currently selected item
2020-07-23 WebUSB: Switch terminal for Xterm.js
2020-07-23 Fixed issue where Programming view would break after switching to another view
2020-07-28 Experimental stm32 firmware
2020-07-28 New dtr+rts reset mechanism
    [uart_driver.c]
2020-07-28 Added short description for STM32 updating
2020-07-28 Modified description for STM32 updating
2020-07-30 Working on interrupt-based SPI driver for leds
2020-07-30 Functional interrupt based led driver that shifts the speaker noise from lower to higher pitched sound
    [firmware-STM32.ioc, led_driver.c, main.c]
2021-05-02 Testing quick workaround for failing ESP32 build
2021-08-27 Added ability to programmatically change USB VID/PID temporarily via i2c in STM32 firmware
2021-08-27 Fixed issue where vid_pid_task() would continuously reset usb bus
    [main.c]
2021-08-27 As reset does not seem to work, now also re-initing tinyusb
    [main.c]
2023-08-15 Removed duplicate STM32 build action
2024-09-24 Fix production build of webusb_site
    Fix message_id being used before declaration
    This causes problems in case the production build where the code is restructured a bit differently than when running the site with yarn serve apparently.
